calithameridi/corevus/assets/corevus-g-v0.2.png

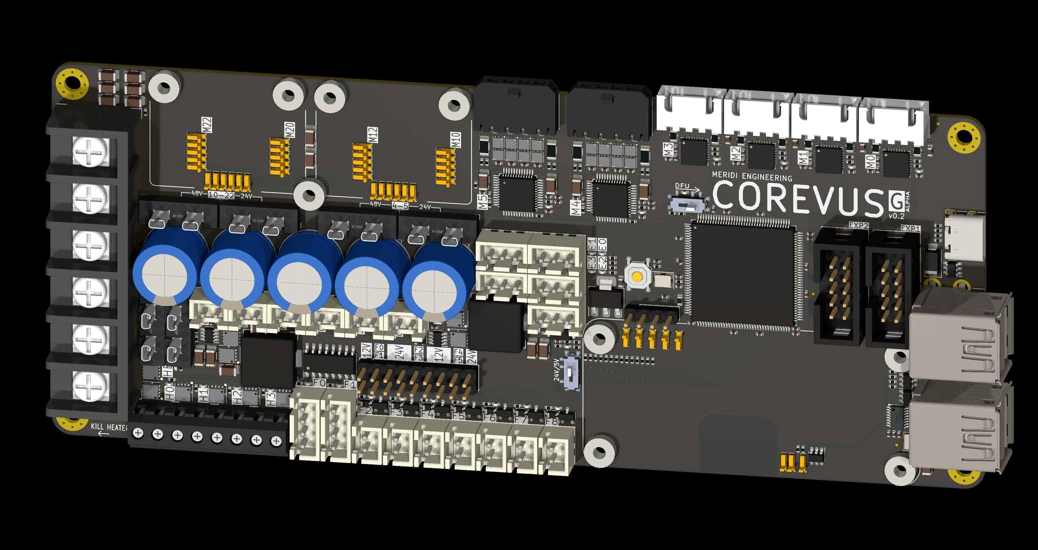
assets/corevus-g-v0.2.png
