calithameridi/corevus/assets/images/CvG-v0.4-closeup.jpg

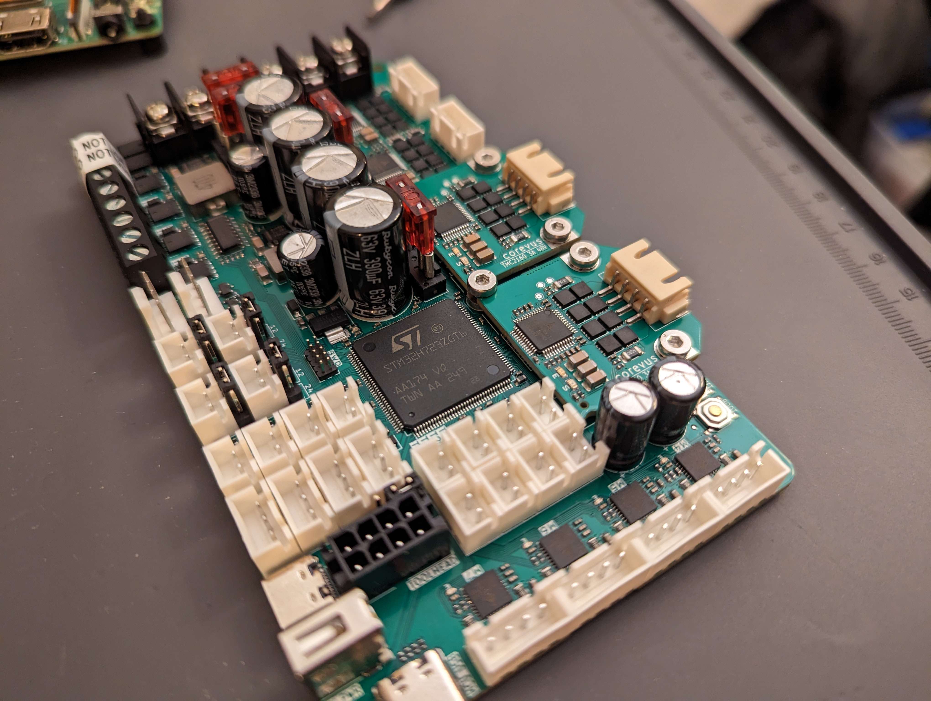
assets/images/CvG-v0.4-closeup.jpg
