calithameridi/corevus/assets/images/CvG-v0.4-topview.jpg

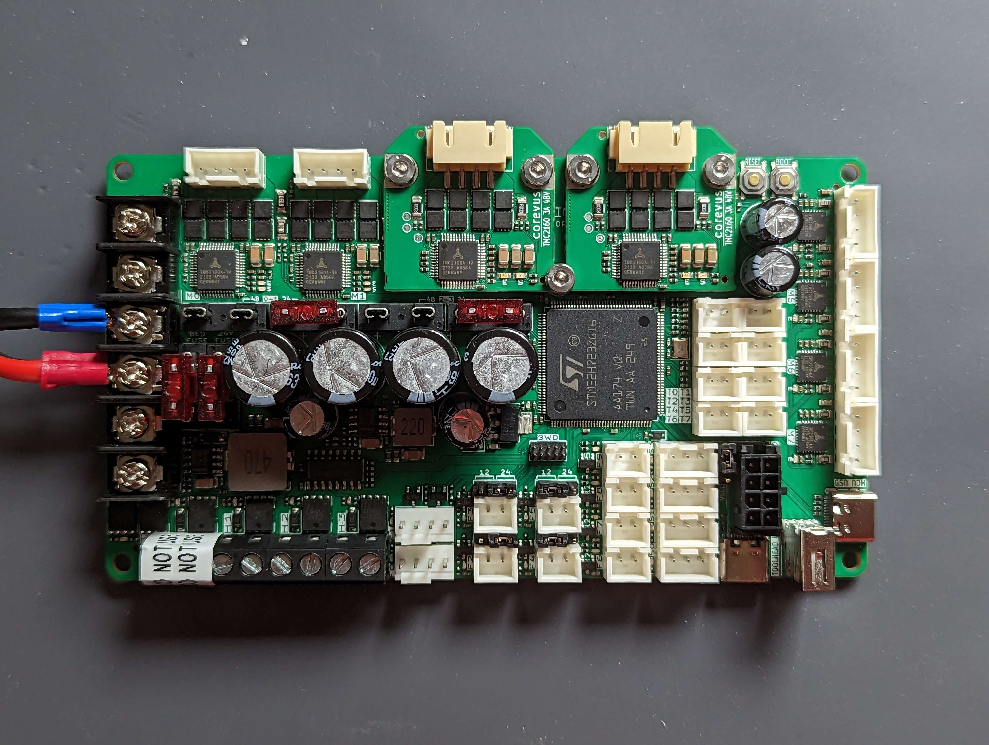
assets/images/CvG-v0.4-topview.jpg
