calithameridi/corevus/assets/images/modules/20240908_corevus_tmc2160.jpeg

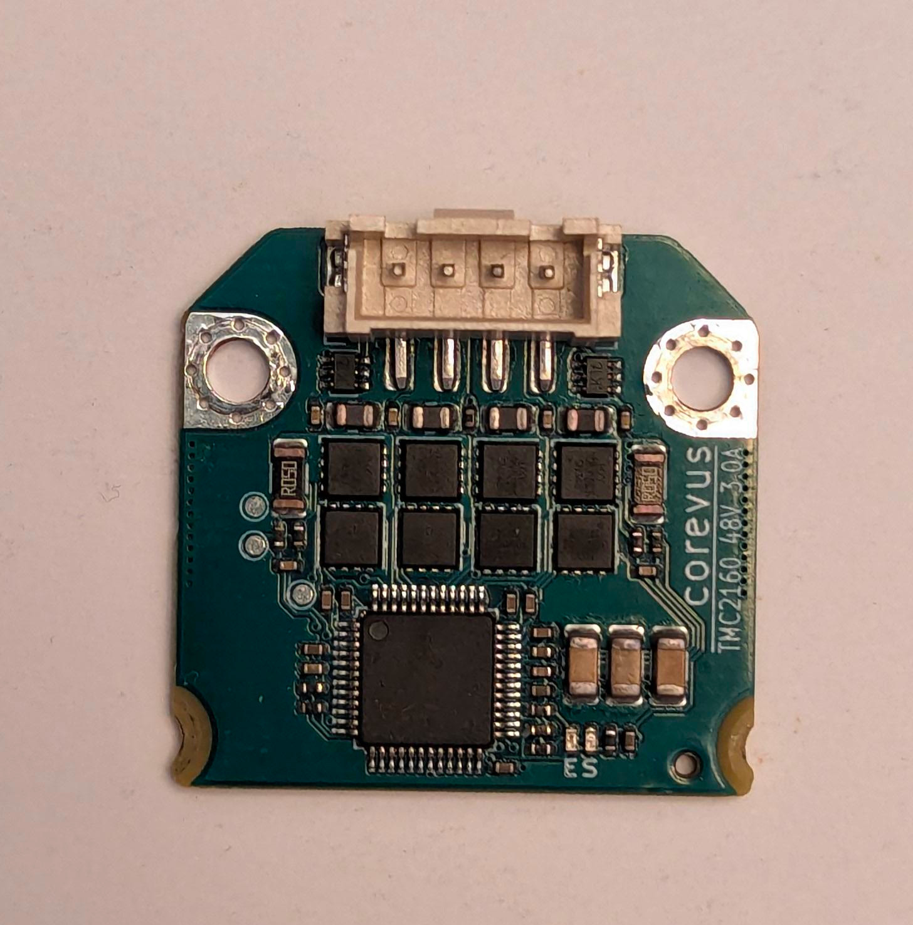
assets/images/modules/20240908_corevus_tmc2160.jpeg
