calithameridi/corevus/assets/images/modules/20240908_corevus_tmc2209.jpeg

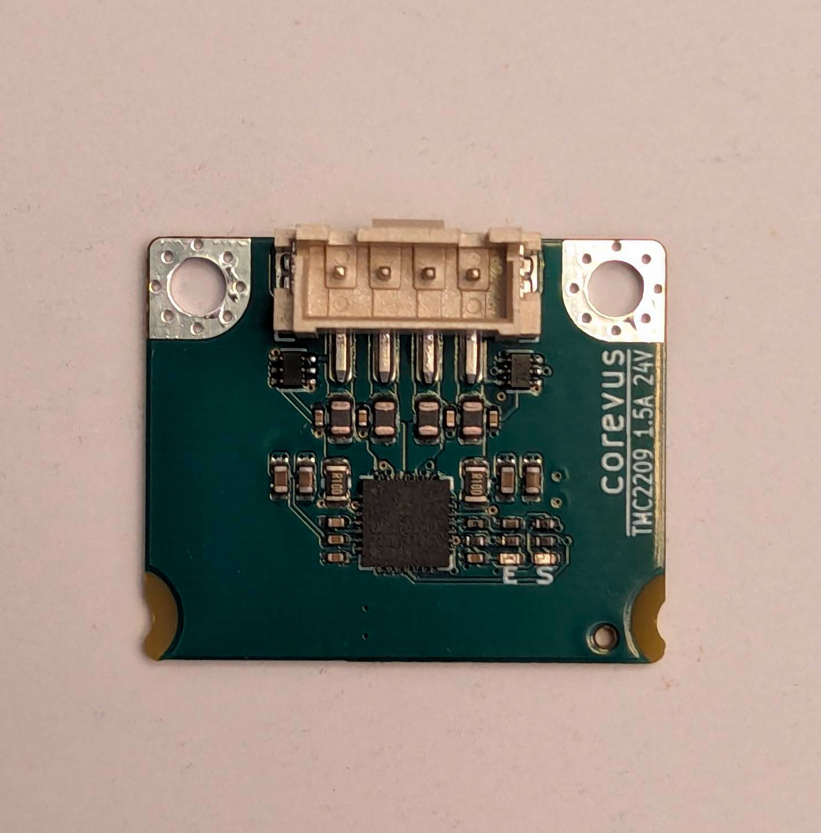
assets/images/modules/20240908_corevus_tmc2209.jpeg
