calithameridi/corevus/assets/images/PXL_20240130_212738815.MP.jpg

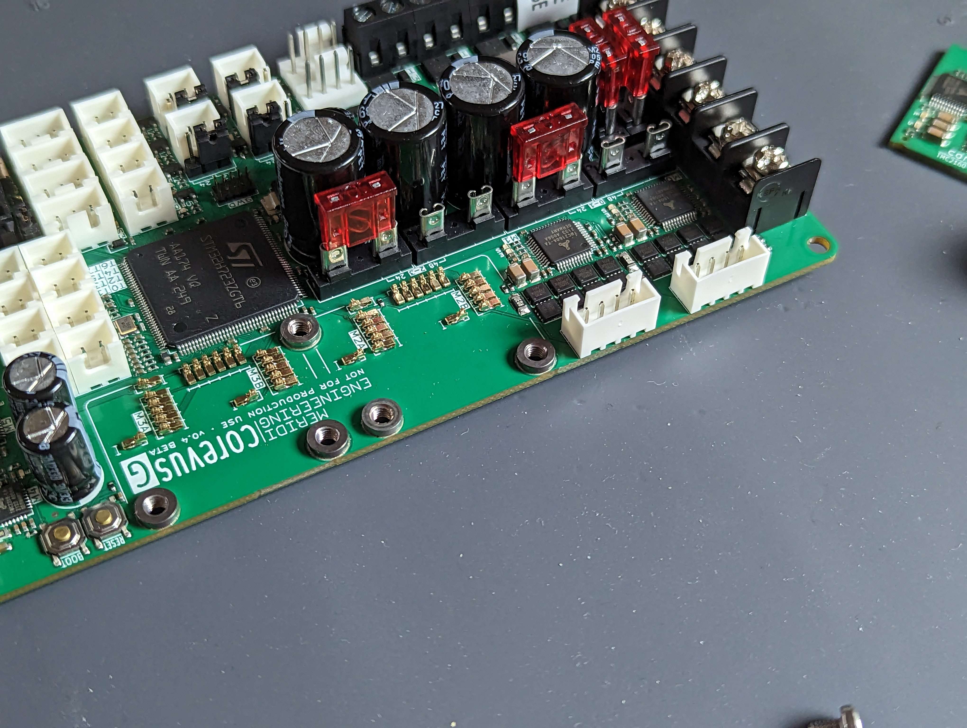
assets/images/PXL_20240130_212738815.MP.jpg
