calithameridi/corevus/assets/images/PXL_20240130_213040972.MP.jpg

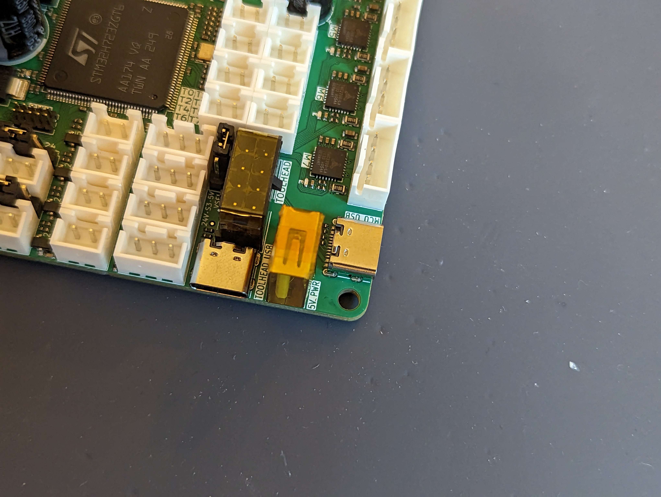
assets/images/PXL_20240130_213040972.MP.jpg
