calithameridi/corevus/hardware/corevus-m++/corevus-m++.step

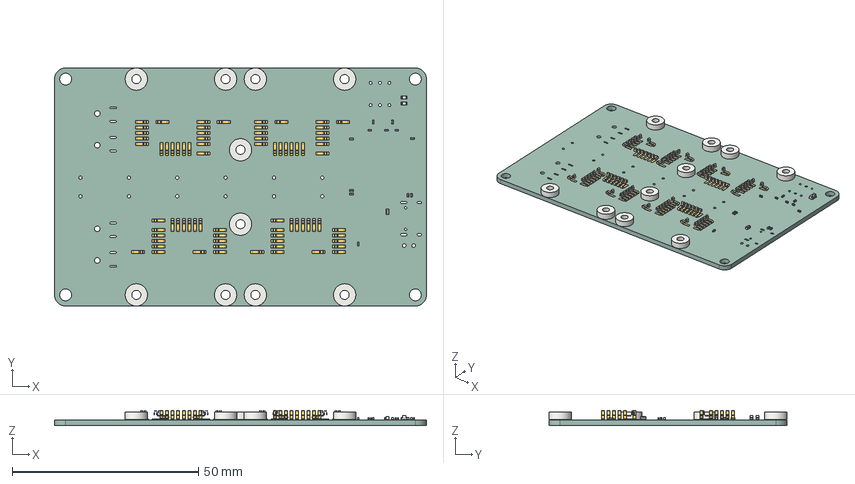
[picture p21: CAD file, 2024-05-26]
hardware/corevus-m++/corevus-m++.step
100.0 x 64.0 x 4.15 mm
Mounting_Wuerth_WA_SMSI_M3_H2mm_9774020360 x 10
C_0402_1005Metric x 12
LED_0603_1608Metric x 2
C_0603_1608Metric
corevus-m++_PCB
