calithameridi/corevus/docs/CvG-v0.4-beta/CvG-v0.4-config-setup.md

# Corevus-G v0.4 beta test manual

Document incomplete, work in progress
*See also*: [Hardware Overview](./CvG-v0.4-hardware-overview.md)

# Critical bug fix

Early testers found [a bug in the Klipper STM32H723 source code](https://github.com/DangerKlippers/danger-klipper/pull/148) that would fail to configure the microcontroller's clock frequency correctly, causing serious problems. I am working on adding this to mainline Klipper, but in the meantime, please [convert your system to DangerKlipper](https://github.com/DangerKlippers/danger-klipper/?tab=readme-ov-file#switch-to-danger-klipper) (which, as of the latest version, has the fix already applied), and reflash the MCU with the following instructions.

# Flashing Klipper
Flashing the firmware is fairly straightforward and mostly similar to how you would flash any control board through USB-DFU:

- Unplug **everything** from the board except the USB connection to the klipper host (or any machine with the klipper build chain). You may find it helpful to take a photo before dismantling attached cables
- On the klipper host, run `cd ~/klipper` to enter the klipper source directory
- Run `make clean` to delete previous builds and `make menuconfig`
- In the configuration menu, select the following parameters: 
	```
	[*] Enable extra low-level configuration options
    Micro-controller Architecture (STMicroelectronics STM32)  --->
    Processor model (STM32H723)  --->
    Bootloader offset (No bootloader)  --->
    Clock Reference (12 MHz crystal)  --->
    Communication interface (USB (on PA11/PA12))  --->
	```
- Save and exit the configuration menu
- Switch the microcontroller into DFU mode by holding down the BOOT pushbutton and then pressing and releasing the RESET pushbutton (the STM32 should show up as '0483:df11 STMicroelectronics STM device in DFU mode')
- Run `make` to compile the Klipper MCU firmware. On most Raspberry Pis with a quad-core processor, use `make -j4` to use all CPU cores and save substantial time.
- Flash the board with `make flash FLASH_DEVICE=0483:df11`. This may return 'error 255', which does not affect functionality
- Check `lsusb`, the board should show up as '1d50:614e OpenMoko, Inc. stm32h723xx'.
- (Re)install the board in accordance to your wiring scheme.

Configuring the board should also be straightforward — with the board connected to your host computer via USB, run `ls /dev/serial/by-id/*` and copy the resulting directory path into the `serial:` section under `[mcu]` in your Klipper config file. 

After doing this, verify in the settings / machine panel that the clock frequency of the STM32H723 MCU is 400 MHz _and not 480 MHz_. If you see 480 MHz, the machine will not work — check that you're on the latest version of DangerKlipper and/or ping me on Discord.

# Configuration 

Reading through the [Klipper configuration reference](https://www.klipper3d.org/Config_Reference.html) will probably be of good help here.

## Pin table
Add the following section to your configuration. This defines human readable pins for pin names such that you won't have to reference the schematic for the microcontroller pin names. For example, you can call `T1` to denote the pin connected to thermistor T1 and `M4_STEP` to denote the pin connected to the M4 driver step signal.

```
[board_pins corevus-g] ### Corevus-G v0.4 Pin Aliases ###
mcu: # specify name given to corevus microcontroller, typically 'mcu'
aliases:
# TMC2160 drivers
	M0_STEP = PG8,  M0_DIR = PG7, M0_EN = PG5,  M0_CS = PG6, M0_DIAG1 = PG4,
	M1_STEP = PD15, M1_DIR = PG2, M1_EN = PD14, M1_CS = PG3, M1_DIAG1 = PD13,
# Driver expansion ports
	M2A_STEP = PB12, M2A_DIR = PE12, M2A_EN = PE13, M2A_CS = PE14, M2A_DIAG = PE15,
	M2B_STEP = PD12, M2B_DIR = PD11, M2B_EN = PD10, M2B_CS = PD9,  M2B_DIAG = PD8,
	M3A_STEP = PF13, M3A_DIR = PF14, M3A_EN = PF15, M3A_CS = PG1,  M3A_DIAG = PG0,
	M3B_STEP = PE11, M3B_DIR = PE10, M3B_EN = PE9,  M3B_CS = PE8,  M3B_DIAG = PE7,
# TMC2208 drivers
	M4_STEP = PF11, M4_DIR = PC4,  M4_EN = PC5,  M4_UART = PF12,
	M5_STEP = PF3,  M5_DIR = PF1,  M5_EN = PF2,  M5_UART = PF4,
	M6_STEP = PC15, M6_DIR = PC13, M6_EN = PC14, M6_UART = PF0,
	M7_STEP = PE4,  M7_DIR = PE2,  M7_EN = PE3,  M7_UART = PE5,
# Heaters
	HB = PD2, H0 = PD1, H1 = PD0, H2 = PD3, H3 = PD4,
# Fans
	F0 = PA10, F1 = PA15,
	F2 = PB4, F3 = PB3, F4 = PB6, F5 = PB5, 
	F6 = PB9, F7 = PB8, F8 = PE6, F9 = PB7,
	F0_FG = PC11, F1_FG = PC10,
# Thermistors
	T0 = PA0, T1 = PA1, T2 = PC2, T3 = PC3,
	T4 = PC0, T5 = PC1, T6 = PF6, T7 = PF7,
	M1_THERM = PB1, M2_THERM = PB0, M3_THERM = PF8,
	M4_THERM = PA4, 5V_THERM = PF9, 12V_THERM = PF10,
# Endstops
	S0 = PG12, S1 = PG13, S2 = PG14, S3 = PG15
```

## Thermistors
Corevus-G features 4 onboard thermistors soldered on to measure temperature in key locations. These temperature sensors not only present a useful diagnostic tool but also provide an extra layer of safety from serious errors such as motor driver misconfigurations. 

Add the following section to your config file. If the default `max_temp` of 85°C is too low, and providing more cooling / airflow to the board is not an option, you may have to increase the `max_temp`. For safety it is not recommended to increase this value past 100°C. 

Driver expansion modules have their own built-in thermistors. If you have drivers installed in ports M2 and/or M3 their temperatures can be read out by uncommenting the relevant sections.

```
### Corevus-G v0.4 Thermistors ###

[thermistor CvBoardTherm]
temperature1: 25.0
resistance1: 10000.0
beta: 3950

[temperature_sensor M1_Driver]
sensor_type: CvBoardTherm
sensor_pin: M1_THERM
min_temp: -20
max_temp: 85

[temperature_sensor M4_Driver]
sensor_type: CvBoardTherm
sensor_pin: M4_THERM
min_temp: -20
max_temp: 85

[temperature_sensor 12V]
sensor_type: CvBoardTherm
sensor_pin: 12V_THERM
min_temp: -20
max_temp: 85

[temperature_sensor 5V]
sensor_type: CvBoardTherm
sensor_pin: 5V_THERM
min_temp: -20
max_temp: 85

# Uncomment if using expansion ports M2 and/or M3

#[temperature_sensor M2_Driver]
#sensor_type: CvBoardTherm
#sensor_pin: M2_THERM
#min_temp: -20
#max_temp: 85

#[temperature_sensor M3_Driver]
#sensor_type: CvBoardTherm
#sensor_pin: M3_THERM
#min_temp: -20
#max_temp: 85
```

## Motors 

The following klipper configuration code uses the TMC5160 module — works, as the two chips are mostly register compatible and Klipper does not use 5160-specific features. A dedicated TMC2160 module is being tested and should be upstreamed soon. 

Important to note: **you must check the driver sense resistor values** and add them to your configuration file. Failure to do so may result in destruction of motors, drivers, or both — this is a scenario that has happened numerous times so save yourself the effort of dealing with an electrical fire. For v0.4 tmc2160s, the value is 30 mΩ — however, due to reported issues with low sense resistances this value is likely to change in the future. Check the physical resistors on the board before configuring!

This code configures the TMC2160 drivers M0 and M1 (just substitute the pin alias names). Start out at a low run current and increase it to your preferred value once you have established that the drivers work.
```
[stepper-<n>]
step_pin: M0_STEP
dir_pin: M0_DIR
enable_pin: !M0_EN
rotation_distance: 
microsteps:
full_steps_per_rotation: 200
endstop_pin:
#position_min: 0
position_endstop:
position_max:
#homing_speed: 5.0
#homing_retract_dist: 5.0
#homing_retract_speed:
#second_homing_speed:
#homing_positive_dir:

[tmc5160 stepper_<n>]
cs_pin: M0_STEP
spi_bus: spi2
interpolate: True
run_current: 1.0
hold_current: 1.0
sense_resistor: 0.03 # YOU MUST CHECK THIS AGAINST YOUR HARDWARE
#stealthchop_threshold: 0
# Relevant for sensorless homing
driver_SGT: 0
diag1_pin:
	# For integrated 2160s this is M0_DIAG1 or M1_DIAG1, for TMC2160 driver expansion modules this is M2A_DIAG or similar (with no '1')

```
This code configures a single TMC2160 driver module bolted to the M2 slot — the driver is electrically connected to the signals labeled with M2A.
