calithameridi/corevus/hardware/motor_drivers/driver-dual-tmc2160/driver-dual-tmc2160.kicad_pcb

## KiCad design hardware/motor_drivers/driver-dual-tmc2160/driver-dual-tmc2160.kicad_pcb (2025-02-08)

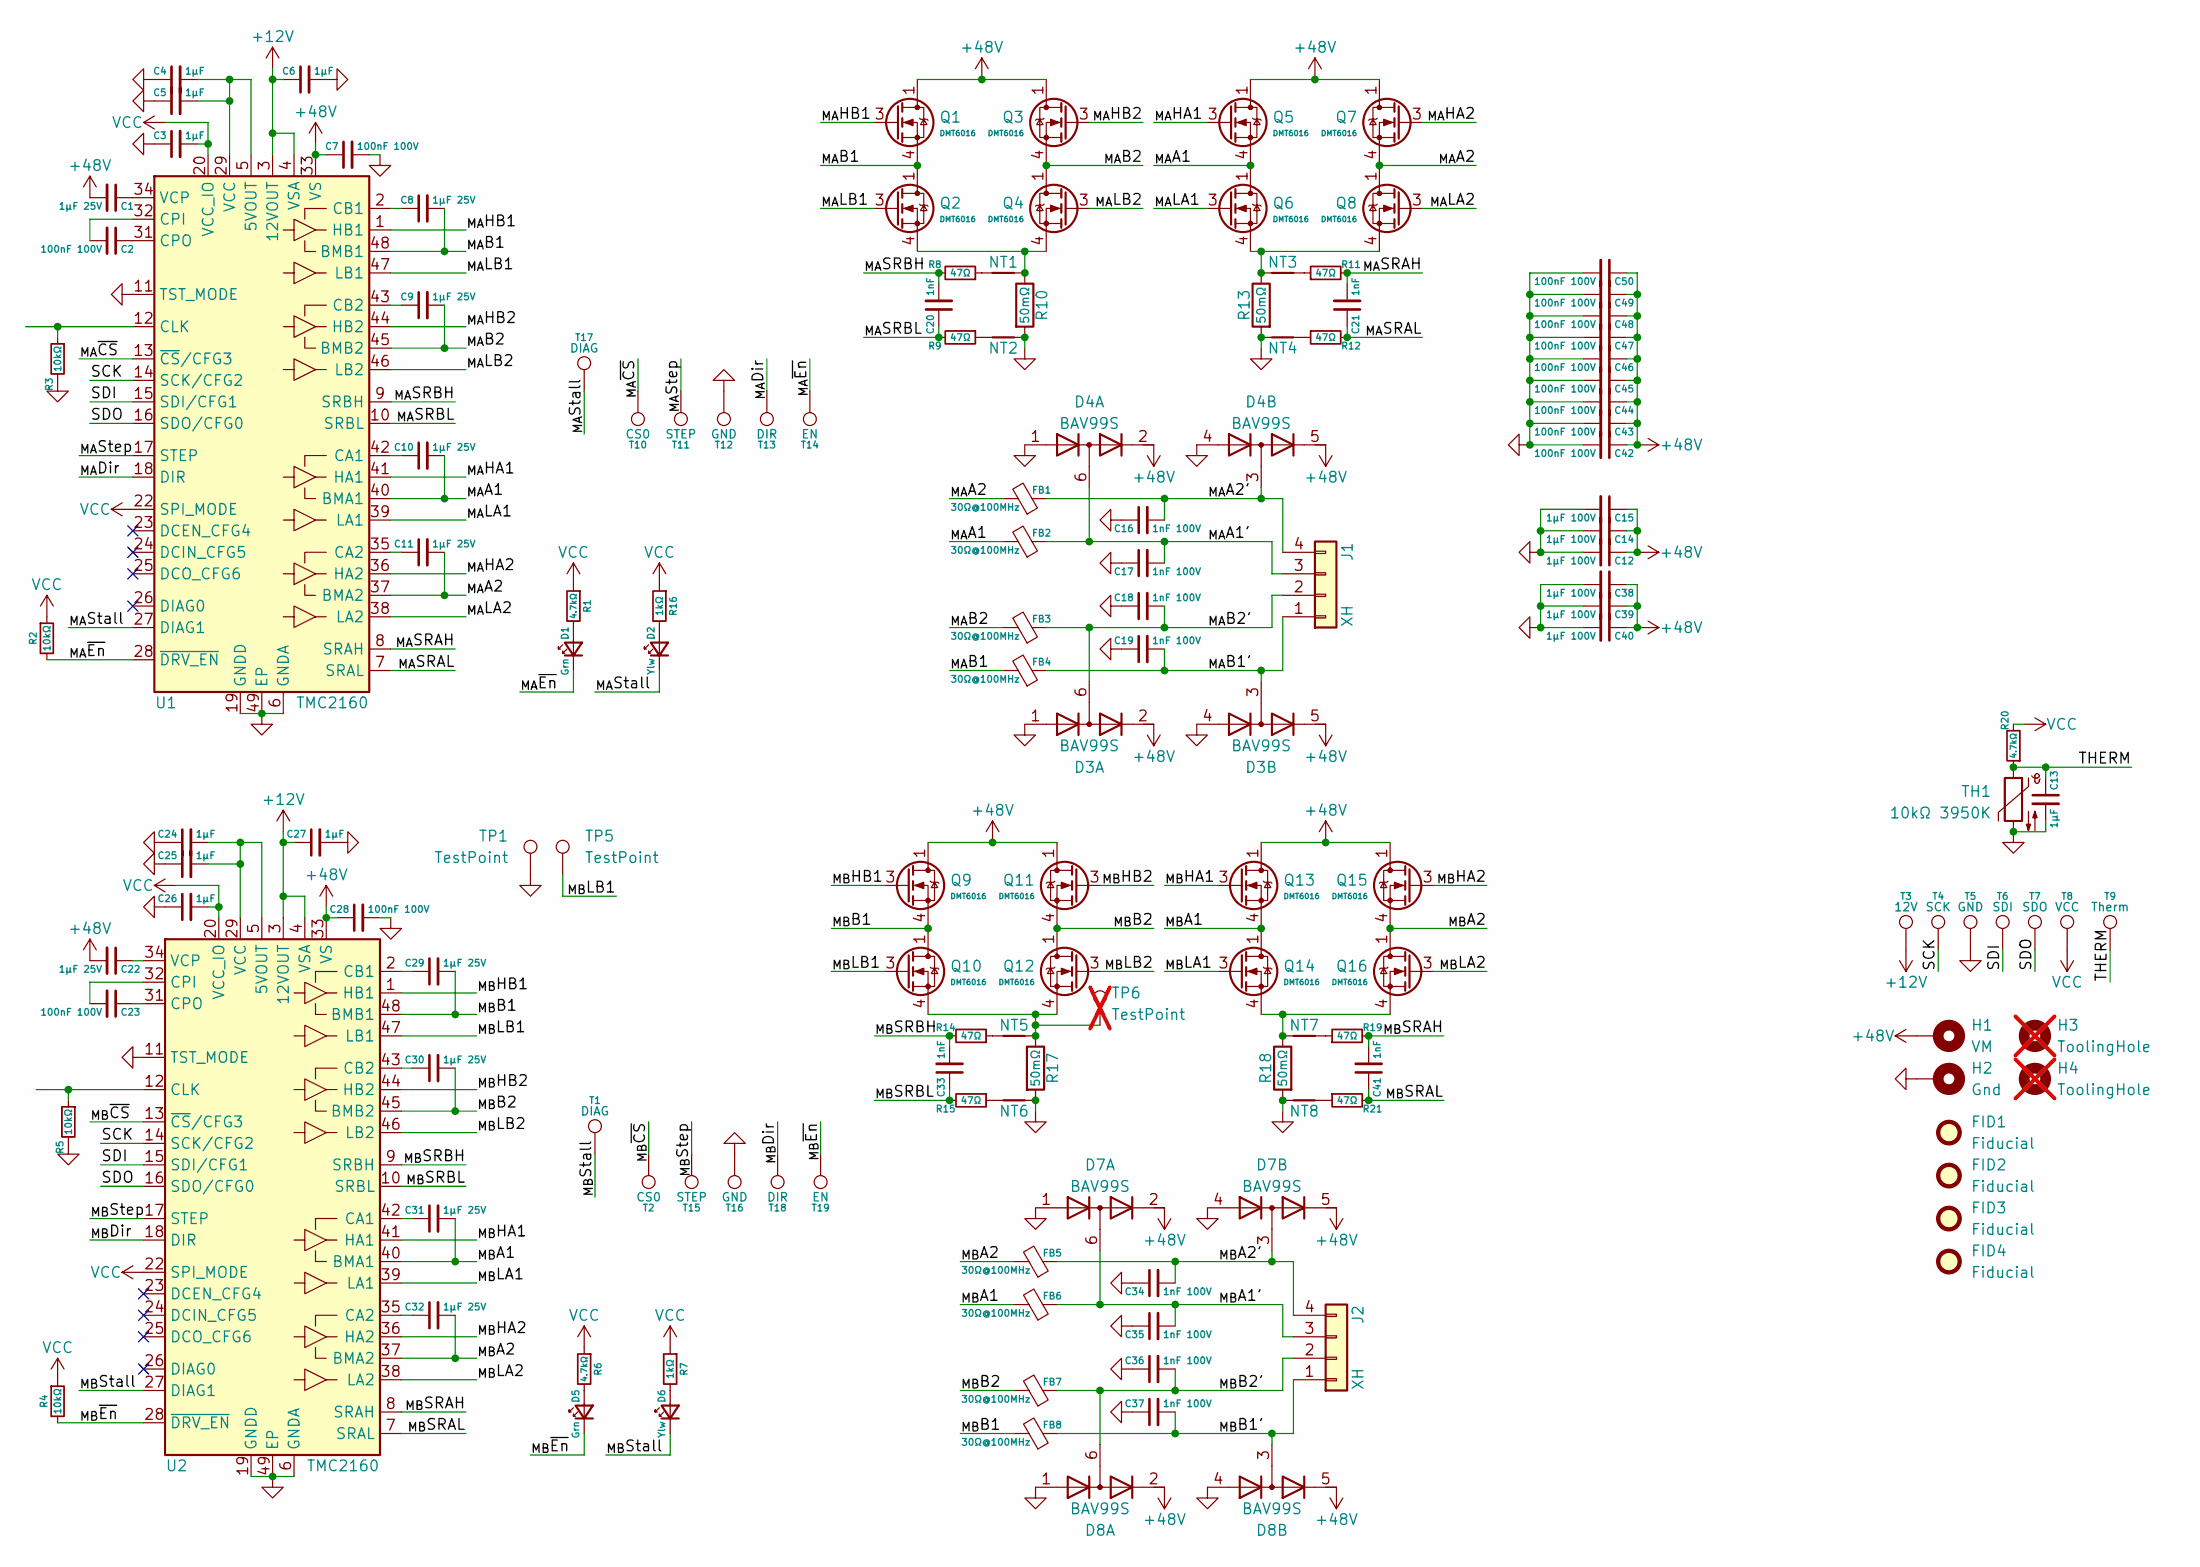
[picture p25: schematic driver-dual-tmc2160.kicad_sch, TMC2160 Stepper Driver Module]

Parts:
C1, C8, C9, C10, C11, C22, C29, C30, C31, C32: 1μF 25V; 0402C
C2, C7, C23, C28, C42, C43, C44, C45, C46, C47, C48, C49, C50: 100nF 100V; 0402C
C3, C5, C25, C26: 1µF; 0402C
C4, C6, C13, C24, C27: 1μF; 0402C
C12, C14, C15, C38, C39, C40: 1μF 100V; C_1206_3216Metric
C16, C17, C18, C19, C34, C35, C36, C37: 1nF 100V; 0402C
C20, C21, C33, C41: 1nF; 0402C
D1, D5: Grn; 0603LED
D2, D6: Ylw; 0603LED
D3, D4, D7, D8: BAV99S; SOT-363_SC-70-6
FB1, FB2, FB3, FB4, FB5, FB6, FB7, FB8: 30Ω@100MHz; R_1206_3216Metric
FID1, FID2, FID3, FID4: Fiducial; Fiducial_0.5mm_Mask1mm
H1: VM; MountingHole_M3_Driver
H2: Gnd; MountingHole_M3_Driver
H3, H4: ToolingHole; not fitted
J1, J2: XH; JST_XH_1x04
NT1, NT2, NT3, NT4, NT5, NT6, NT7, NT8: NetTie_2; NetTie-2_SMD_Pad0.15mm
Q1, Q2, Q3, Q4, Q5, Q6, Q7, Q8, Q9, Q10, Q11, Q12, Q13, Q14, Q15, Q16: DMT6016; DMT6016LFDF; LCSC Part C460205
R1, R6, R20: 4.7kΩ; 0402R
R2, R3, R4, R5: 10kΩ; 0402R
R7, R16: 1kΩ; 0402R
R8, R9, R11, R12, R14, R15, R19, R21: 47Ω; 0402R
R10, R13, R17, R18: 50mΩ; R_1206_3216Metric
T1, T17: DIAG; LGA_Land_2.5mm
T2, T10: CS0; LGA_Land_2.5mm
T3: 12V; LGA_Land_2.5mm
T4: SCK; LGA_Land_2.5mm
T5, T12, T16: GND; LGA_Land_2.5mm
T6: SDI; LGA_Land_2.5mm
T7: SDO; LGA_Land_2.5mm
T8: VCC; LGA_Land_2.5mm
T9: Therm; LGA_Land_2.5mm
T11, T15: STEP; LGA_Land_2.5mm
T13, T18: DIR; LGA_Land_2.5mm
T14, T19: EN; LGA_Land_2.5mm
TH1: 10kΩ 3950K; 0402R
TP1, TP5: TestPoint; TestPoint_Pad_D1.0mm
TP6: TestPoint; TestPoint_Pad_D1.0mm; not fitted
U1, U2: TMC2160; TMCx160

Connections:
+12V: C6.1, C27.1, T3.1, U1.3 (12VOUT), U1.4 (VSA), U2.3 (12VOUT), U2.4 (VSA)
+48V: C1.2, C7.1, C12.1, C14.1, C15.1, C22.2, C28.1, C38.1, C39.1, C40.1, C42.1, C43.1, C44.1, C45.1, C46.1, C47.1, C48.1, C49.1, C50.1, D3.2 (K2), D3.5 (K4), D4.2 (K2), D4.5 (K4), D7.2 (K2), D7.5 (K4), D8.2 (K2), D8.5 (K4), H1.1, Q1.1 (D), Q1.2 (D), Q1.5 (D), Q1.6 (D), Q1.8 (D), Q3.1 (D), Q3.2 (D), Q3.5 (D), Q3.6 (D), Q3.8 (D), Q5.1 (D), Q5.2 (D), Q5.5 (D), Q5.6 (D), Q5.8 (D), Q7.1 (D), Q7.2 (D), Q7.5 (D), Q7.6 (D), Q7.8 (D), Q9.1 (D), Q9.2 (D), Q9.5 (D), Q9.6 (D), Q9.8 (D), Q11.1 (D), Q11.2 (D), Q11.5 (D), Q11.6 (D), Q11.8 (D), Q13.1 (D), Q13.2 (D), Q13.5 (D), Q13.6 (D), Q13.8 (D), Q15.1 (D), Q15.2 (D), Q15.5 (D), Q15.6 (D), Q15.8 (D), U1.33 (VS), U2.33 (VS)
/SCK: T4.1, U1.14 (SCK/CFG2), U2.14 (SCK/CFG2)
/SDI: T6.1, U1.15 (SDI/CFG1), U2.15 (SDI/CFG1)
/SDO: T7.1, U1.16 (SDO/CFG0), U2.16 (SDO/CFG0)
/THERM: C13.1, R20.1, T9.1, TH1.1
/_{MA}A1: C10.2, FB2.2, Q5.4 (S), Q5.7 (S), Q6.1 (D), Q6.2 (D), Q6.5 (D), Q6.6 (D), Q6.8 (D), U1.40 (BMA1)
/_{MA}A1': C17.2, D4.6 (K3A4), FB2.1, J1.3
/_{MA}A2: C11.2, FB1.2, Q7.4 (S), Q7.7 (S), Q8.1 (D), Q8.2 (D), Q8.5 (D), Q8.6 (D), Q8.8 (D), U1.37 (BMA2)
/_{MA}A2': C16.2, D4.3 (K1A2), FB1.1, J1.4
/_{MA}B1: C8.2, FB4.2, Q1.4 (S), Q1.7 (S), Q2.1 (D), Q2.2 (D), Q2.5 (D), Q2.6 (D), Q2.8 (D), U1.48 (BMB1)
/_{MA}B1': C19.2, D3.3 (K1A2), FB4.1, J1.1
/_{MA}B2: C9.2, FB3.2, Q3.4 (S), Q3.7 (S), Q4.1 (D), Q4.2 (D), Q4.5 (D), Q4.6 (D), Q4.8 (D), U1.45 (BMB2)
/_{MA}B2': C18.2, D3.6 (K3A4), FB3.1, J1.2
/_{MA}Dir: T13.1, U1.18 (DIR)
/_{MA}HA1: Q5.3 (G), U1.41 (HA1)
/_{MA}HA2: Q7.3 (G), U1.36 (HA2)
/_{MA}HB1: Q1.3 (G), U1.1 (HB1)
/_{MA}HB2: Q3.3 (G), U1.44 (HB2)
/_{MA}LA1: Q6.3 (G), U1.39 (LA1)
/_{MA}LA2: Q8.3 (G), U1.38 (LA2)
/_{MA}LB1: Q2.3 (G), U1.47 (LB1)
/_{MA}LB2: Q4.3 (G), U1.46 (LB2)
/_{MA}SRAH: C21.2, R11.2, U1.8 (SRAH)
/_{MA}SRAL: C21.1, R12.2, U1.7 (SRAL)
/_{MA}SRBH: C20.2, R8.2, U1.9 (SRBH)
/_{MA}SRBL: C20.1, R9.2, U1.10 (SRBL)
/_{MA}Stall: D2.1 (K), T17.1, U1.27 (DIAG1)
/_{MA}Step: T11.1, U1.17 (STEP)
/_{MA}~CS: T10.1, U1.13 (~CS/CFG3)
/_{MA}~En: D1.1 (K), R2.2, T14.1, U1.28 (~DRV_EN)
/_{MB}A1: C31.2, FB6.2, Q13.4 (S), Q13.7 (S), Q14.1 (D), Q14.2 (D), Q14.5 (D), Q14.6 (D), Q14.8 (D), U2.40 (BMA1)
/_{MB}A1': C35.2, D7.6 (K3A4), FB6.1, J2.3
/_{MB}A2: C32.2, FB5.2, Q15.4 (S), Q15.7 (S), Q16.1 (D), Q16.2 (D), Q16.5 (D), Q16.6 (D), Q16.8 (D), U2.37 (BMA2)
/_{MB}A2': C34.2, D7.3 (K1A2), FB5.1, J2.4
/_{MB}B1: C29.2, FB8.2, Q9.4 (S), Q9.7 (S), Q10.1 (D), Q10.2 (D), Q10.5 (D), Q10.6 (D), Q10.8 (D), U2.48 (BMB1)
/_{MB}B1': C37.2, D8.3 (K1A2), FB8.1, J2.1
/_{MB}B2: C30.2, FB7.2, Q11.4 (S), Q11.7 (S), Q12.1 (D), Q12.2 (D), Q12.5 (D), Q12.6 (D), Q12.8 (D), U2.45 (BMB2)
/_{MB}B2': C36.2, D8.6 (K3A4), FB7.1, J2.2
/_{MB}Dir: T18.1, U2.18 (DIR)
/_{MB}HA1: Q13.3 (G), U2.41 (HA1)
/_{MB}HA2: Q15.3 (G), U2.36 (HA2)
/_{MB}HB1: Q9.3 (G), U2.1 (HB1)
/_{MB}HB2: Q11.3 (G), U2.44 (HB2)
/_{MB}LA1: Q14.3 (G), U2.39 (LA1)
/_{MB}LA2: Q16.3 (G), U2.38 (LA2)
/_{MB}LB1: Q10.3 (G), TP5.1, U2.47 (LB1)
/_{MB}LB2: Q12.3 (G), U2.46 (LB2)
/_{MB}SRAH: C41.2, R19.2, U2.8 (SRAH)
/_{MB}SRAL: C41.1, R21.2, U2.7 (SRAL)
/_{MB}SRBH: C33.2, R14.2, U2.9 (SRBH)
/_{MB}SRBL: C33.1, R15.2, U2.10 (SRBL)
/_{MB}Stall: D6.1 (K), T1.1, U2.27 (DIAG1)
/_{MB}Step: T15.1, U2.17 (STEP)
/_{MB}~CS: T2.1, U2.13 (~CS/CFG3)
/_{MB}~En: D5.1 (K), R4.2, T19.1, U2.28 (~DRV_EN)
GND: C3.1, C4.1, C5.1, C6.2, C7.2, C12.2, C13.2, C14.2, C15.2, C16.1, C17.1, C18.1, C19.1, C24.1, C25.1, C26.1, C27.2, C28.2, C34.1, C35.1, C36.1, C37.1, C38.2, C39.2, C40.2, C42.2, C43.2, C44.2, C45.2, C46.2, C47.2, C48.2, C49.2, C50.2, D3.1 (A1), D3.4 (A3), D4.1 (A1), D4.4 (A3), D7.1 (A1), D7.4 (A3), D8.1 (A1), D8.4 (A3), H2.1, NT2.2, NT4.1, NT6.2, NT8.1, R3.2, R5.2, R10.2, R13.2, R17.2, R18.2, T5.1, T12.1, T16.1, TH1.2, TP1.1, U1.6 (GNDA), U1.11 (TST_MODE), U1.19 (GNDD), U1.30 (GNDD), U1.49 (EP), U2.6 (GNDA), U2.11 (TST_MODE), U2.19 (GNDD), U2.30 (GNDD), U2.49 (EP)
unnamed: D1.2 (A), R1.2
unnamed: D2.2 (A), R16.2
unnamed: D5.2 (A), R6.2
unnamed: D6.2 (A), R7.2
unnamed: NT1.1, R8.1
unnamed: NT1.2, Q2.4 (S), Q2.7 (S), Q4.4 (S), Q4.7 (S), R10.1
unnamed: NT2.1, R9.1
unnamed: NT3.1, Q6.4 (S), Q6.7 (S), Q8.4 (S), Q8.7 (S), R13.1
unnamed: NT3.2, R11.1
unnamed: NT4.2, R12.1
unnamed: NT5.1, R14.1
unnamed: NT5.2, Q10.4 (S), Q10.7 (S), Q12.4 (S), Q12.7 (S), R17.1, TP6.1
unnamed: NT6.1, R15.1
unnamed: NT7.1, Q14.4 (S), Q14.7 (S), Q16.4 (S), Q16.7 (S), R18.1
unnamed: NT7.2, R19.1
unnamed: NT8.2, R21.1
unnamed: C4.2, C5.2, U1.5 (5VOUT), U1.29 (VCC)
unnamed: C10.1, U1.42 (CA1)
unnamed: C11.1, U1.35 (CA2)
unnamed: C8.1, U1.2 (CB1)
unnamed: C9.1, U1.43 (CB2)
unnamed: R3.1, U1.12 (CLK)
unnamed: C2.2, U1.32 (CPI)
unnamed: C2.1, U1.31 (CPO)
unnamed: C1.1, U1.34 (VCP)
unnamed: C24.2, C25.2, U2.5 (5VOUT), U2.29 (VCC)
unnamed: C31.1, U2.42 (CA1)
unnamed: C32.1, U2.35 (CA2)
unnamed: C29.1, U2.2 (CB1)
unnamed: C30.1, U2.43 (CB2)
unnamed: R5.1, U2.12 (CLK)
unnamed: C23.2, U2.32 (CPI)
unnamed: C23.1, U2.31 (CPO)
unnamed: C22.1, U2.34 (VCP)
VCC: C3.2, C26.2, R1.1, R2.1, R4.1, R6.1, R7.1, R16.1, R20.2, T8.1, U1.20 (VCC_IO), U1.21 (VCC_IO), U1.22 (SPI_MODE), U2.20 (VCC_IO), U2.21 (VCC_IO), U2.22 (SPI_MODE)

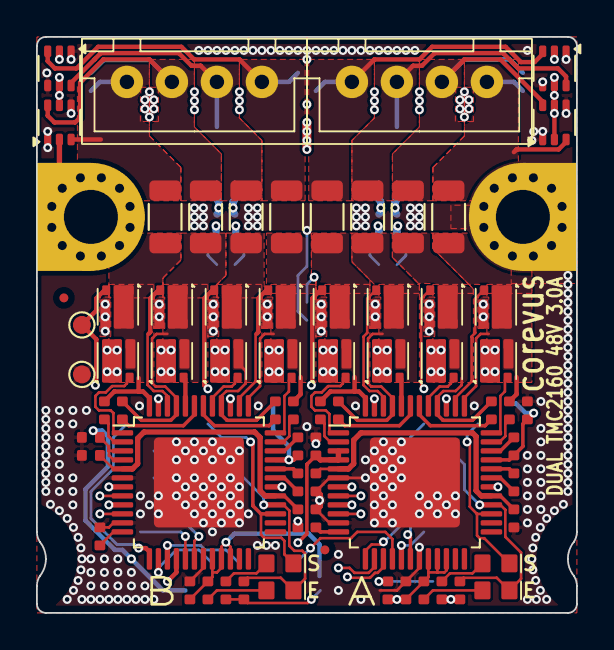
[picture p26: board driver-dual-tmc2160.kicad_pcb from above]

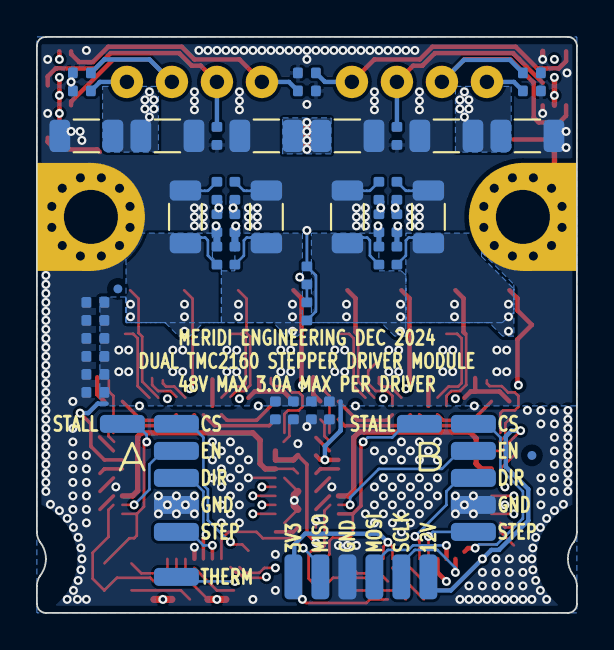
[picture p27: board driver-dual-tmc2160.kicad_pcb from below]

Board: 4 copper layers, 30.0 x 32.0 mm, 143 parts (71 on the bottom side), 92 nets.
