calithameridi/corevus/hardware/corevus-toolboard/corevus-toolboard.kicad_pcb

## KiCad design hardware/corevus-toolboard/corevus-toolboard.kicad_pcb (2025-02-08)

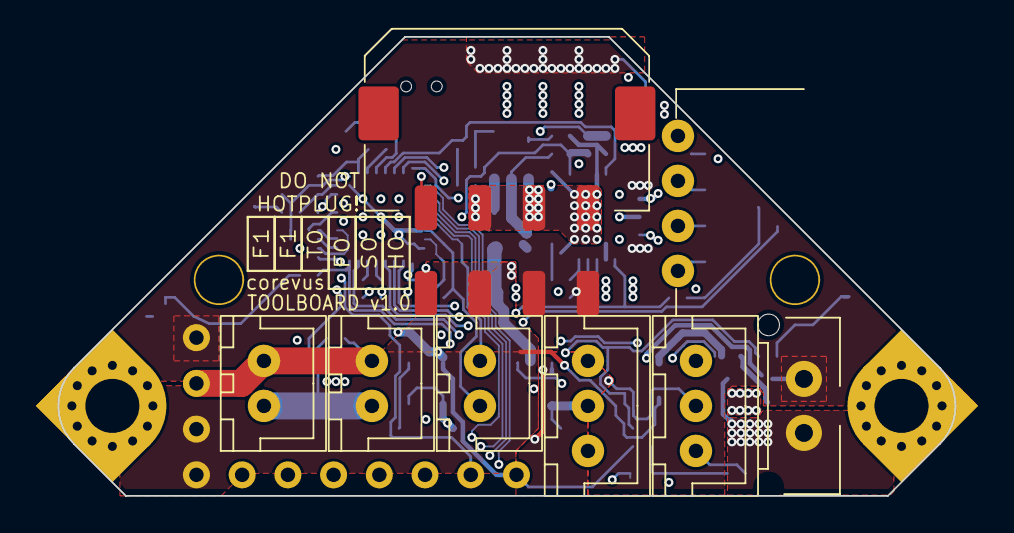
[picture p28: board corevus-toolboard.kicad_pcb from above]

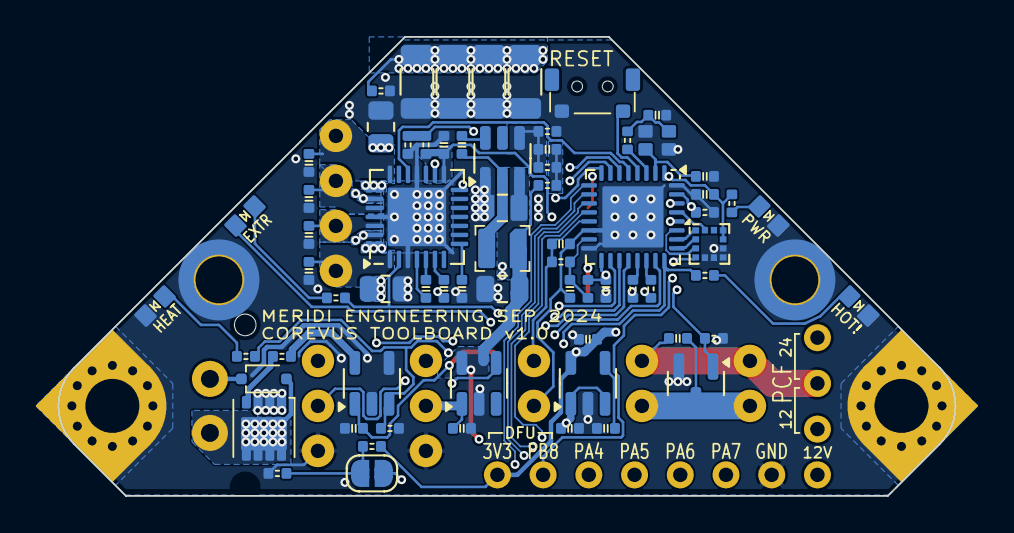
[picture p29: board corevus-toolboard.kicad_pcb from below]

Board: 4 copper layers, 49.8 x 25.5 mm, 84 parts (72 on the bottom side), 62 nets.

Parts:
C1, C4, C5, C6, C11, C12, C13, C26, C34: 1µF; 0402C
C2, C3: 10pF; 0402C
C7: 100nF; 0402C
C8: 100nF 16V; 0402C
C9: 22nF 50V; 0402C
C14, C15, C16, C17: 10µF 50V; C_1206_3216Metric
C18, C19, C20, C21: 470pF; 0402C
C23: 100nF 50V; 0402C
C28: 68pF; 0402C
C29: 100nF 25V; 0402C
C31: 10nF; 0402C
C32: 10µF 25V; C_0805_2012Metric
C33: 10µF; C_0805_2012Metric
D1: 4148; D_SOD-323
D2: Red; 0603LED
D3: Grn; 0603LED
D4: Wht; 0603LED
D5: Ylw; 0603LED
FB1: GZ1005; 0402
H1, H2: M3 Hole; MountingHole_M3_Driver_Corner
H3, H4: M2 Standoff; Sinhoo_TH162010
J1: MF3 1x2P; Molex_Micro-Fit-3.0_436500215
J2, J9: XH 1x3P; JST_XH_1x03
J3: MX3.0 2x4P; XKB_X3025WRS-2x04E
J4: XH 1x4P; JST_XH_1x04-Side
J5, J6, J7: XH 1x2P; JST_XH_1x02
J8: 1x8P; PinHeader_1x08_P2.54mm_Vertical
J10: 1x3P; PinHeader_1x03_P2.54mm_Vertical
JP1: Jumper_2_Small_Open; SolderJumper-2_P1.3mm_Open_RoundedPad1.0x1.5mm
L1: 10µH; L_Changjiang_FTC2520
NT1: NetTie_2; NetTie-2_SMD_Pad0.1mm
Q2: NMOS; MOSFET_DFN8
Q4: AO3400; SOT-23
R1, R7, R16: 4.7kΩ; 0402R
R2: 100kΩ; 0402R
R3, R4: 33Ω; 0402R
R5, R6: 100mΩ; R_0805_2012Metric
R8, R13, R17, R21: 2.2kΩ; 0402R
R9: 0Ω; 0402R
R10: 20kΩ; 0402R
R11: 150kΩ; 0402R
R12: 1kΩ; 0402R
R14, R19: 10kΩ; 0402R
R15: 51Ω; 0402R
R20: 510kΩ; 0402R
SW1: Reset; ShouHan_TS24CA
TH1, TH2: 10kΩ 3950K; 0402R
U1: LIS2DE12; LGA-12_2x2mm_P0.5mm
U2: TPS54302; SOT-23-6
U3: STM32G431KBU3; QFN-32-1EP_5x5mm_P0.5mm_EP3.45x3.45mm
U4: TMC2209-LA; TQFN-28-1EP_5x5mm_P0.5mm_EP3.25x3.25mm_ThermalVias
U6: SPX3819M5-L-3-3; SOT-23-5
U7: TPS2069CDBV; SOT-23-5
U8: UCC27517; SOT-23-5
Y1: XRCGB25; Crystal_SMD_2016-4Pin_2.0x1.6mm

Connections:
+3.3V: C5.1, C11.1, C12.1, C34.2, D3.2 (A), FB1.2, J8.8, R7.2, R16.2, R17.2, U1.9 (Vdd), U1.10 (Vdd_IO), U3.1 (VDD), U3.17 (VDD), U4.15 (VCC_IO), U6.5 (OUT)
+5V: C1.2, C33.1, J9.2, L1.2, R15.1, U6.1 (IN), U6.3 (EN), U7.5 (IN)
+12V: C29.1, C32.1, J3.6, J8.1, J10.3, U2.3 (VIN), U8.1 (VDD)
+24V: C8.2, C14.1, C15.1, C16.1, C17.1, D1.1 (K), J1.2, J3.7, J3.8, J10.1, R20.1, U4.22 (VS), U4.28 (VS)
/A1: C19.1, J4.3, U4.24 (OA1)
/A2: C18.1, J4.4, U4.21 (OA2)
/ACCEL_CS: U1.2 (~CS), U3.25 (PA15)
/ACCEL_INT1: U1.12 (INT1), U3.29 (PB6)
/B1: C21.1, J4.1, U4.1 (OB2)
/B2: C20.1, J4.2, U4.26 (OB1)
/BOOT0: J8.7, R2.2, U3.31 (PB8)
/D+: J3.5, R3.2
/D+': R3.1, U3.22 (USB_DP)
/D-: J3.1, R4.2
/D-': R4.1, U3.21 (USB_DM)
/Dir: U3.5 (PA0), U4.19 (DIR)
/F0: R8.2, U3.24 (PA14), U7.4 (EN)
/F0_FG: J2.3, U3.19 (PA9)
/F1: Q4.1 (G), R14.1, U3.30 (PB7)
/H0: R1.2, R19.2, U3.23 (PA13), U8.3 (IN+)
/H0_Gate: R9.2, U8.5 (OUT)
/PA4: J8.6, JP1.2 (B), U3.9 (ADC2_IN17)
/PA5: J8.5, U3.10 (ADC2_IN13)
/PA6: J8.4, U3.11 (ADC2_IN3)
/PA7: J8.3, U3.12 (ADC2_IN4)
/PCF_V+: C23.1, J6.2, J7.2, J10.2
/S0: J9.3, U3.20 (PA10)
/SPI1_MISO: U1.3 (SA0/SDO), U3.27 (SPI1_MISO)
/SPI1_MOSI: U1.4 (SDA/SDI), U3.28 (SPI1_MOSI)
/SPI1_SCK: U1.1 (SCL/SPC), U3.26 (SPI1_SCK)
/Step: U3.7 (PA2), U4.16 (STEP)
/T0: C26.1, J5.2, R13.1, U3.13 (PB0)
/UART: U3.8 (PA3), U4.14 (PDN/UART)
/_{FET}Therm: JP1.1 (A), R7.1, TH2.1
/_{Motor}Therm: R16.1, TH1.1, U3.6 (ADC1_IN2)
/~En: R21.2, U3.18 (PA8), U4.2 (~EN)
/~Reset: SW1.1, U3.4 (PG10)
GND: C1.1, C2.2, C3.2, C4.2, C5.2, C6.2, C11.2, C12.2, C14.2, C15.2, C16.2, C17.2, C18.2, C19.2, C20.2, C21.2, C29.2, C31.1, C32.2, C33.2, C34.1, D2.1 (K), D4.1 (K), D5.1 (K), H1.1, H2.1, H3.1, H4.1, J2.1, J3.2, J3.3, J3.4, J8.2, J9.1, NT1.1, Q2.1 (S), Q2.2 (S), Q2.3 (S), Q4.2 (S), R2.1, R5.1, R6.1, R10.2, R14.2, R19.1, R20.2, SW1.2, TH1.2, TH2.2, U1.5 (RES), U1.6 (GND), U1.7 (GND), U1.8 (GND), U2.1 (GND), U3.16 (VSS), U3.32 (VSS), U3.33 (VSS), U4.3 (GND), U4.18 (Gnd), U4.25 (NC), U4.29 (Pad), U6.2 (GND), U7.2 (GND), U8.2 (GND), U8.4 (IN-), Y1.2, Y1.4
unnamed: C3.1, R12.1, Y1.1
unnamed: C28.1, R11.1, R15.2
unnamed: D1.2 (A), J1.1, Q2.5 (D), Q2.6 (D), Q2.7 (D), Q2.8 (D)
unnamed: D2.2 (A), R1.1
unnamed: D3.1 (K), R21.1
unnamed: D4.2 (A), R17.1
unnamed: D5.2 (A), R8.1
unnamed: C6.1, J2.2, U7.1 (OUT)
unnamed: C23.2, J6.1, J7.1, Q4.3 (D)
unnamed: Q2.4 (G), R9.1
unnamed: C7.1, U2.6 (BOOT)
unnamed: C28.2, R10.1, R11.2, U2.4 (FB)
unnamed: C7.2, L1.1, U2.2 (SW)
unnamed: C2.1, U3.2 (RCC_OSC_IN), Y1.3
unnamed: R12.2, U3.3 (RCC_OSC_OUT)
unnamed: C4.1, U4.8 (5VOUT)
unnamed: R5.2, U4.23 (BRA)
unnamed: R6.2, U4.27 (BRB)
unnamed: C9.2, U4.5 (CPI)
unnamed: C9.1, U4.4 (CPO)
unnamed: C8.1, U4.6 (VCP)
unnamed: C31.2, U6.4 (BP)
VDDA: C13.2, FB1.1, R13.2, U3.15 (VDDA)
VSSA: C13.1, C26.2, J5.1, NT1.2, U3.14 (VSSA)
