calithameridi/corevus/hardware/toolboard-expansions/expansion-4x-thermistor/expansion-4x-thermistor.kicad_pcb

## KiCad design hardware/toolboard-expansions/expansion-4x-thermistor/expansion-4x-thermistor.kicad_pcb (2024-09-03)

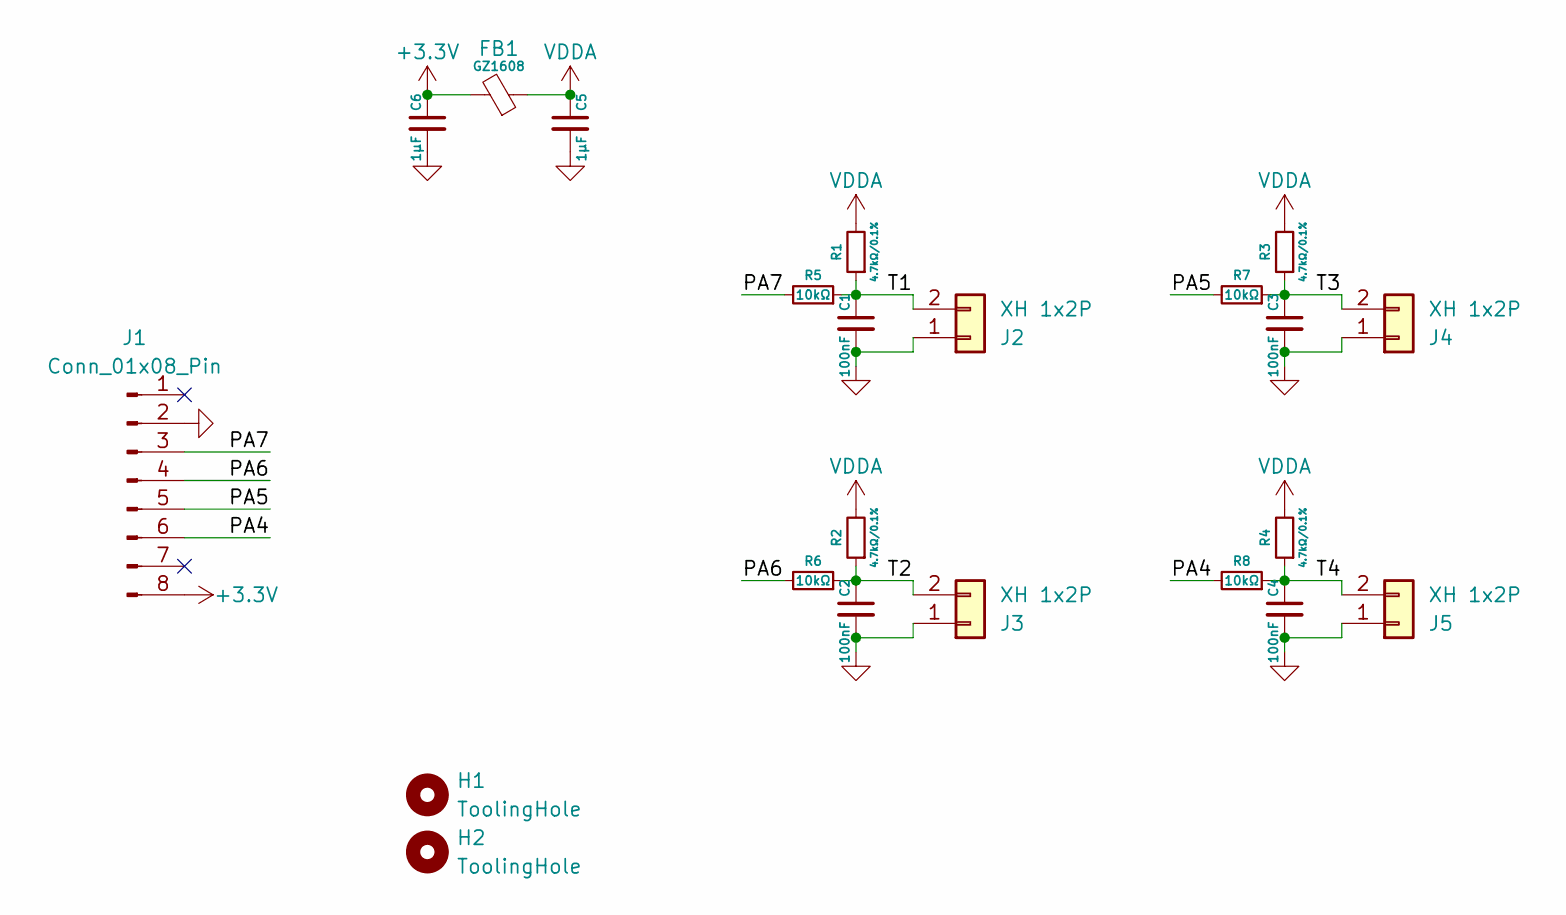
[picture p30: schematic expansion-4x-thermistor.kicad_sch]

Parts:
C1, C2, C3, C4: 100nF; 0402C
C5, C6: 1µF; 0402C
FB1: GZ1608; 0603
H1, H2: ToolingHole
J1: Conn_01x08_Pin; PinHeader_1x08_P2.54mm_Vertical
J2, J3, J4, J5: XH 1x2P; JST_XH_1x02-Side
R1, R2, R3, R4: 4.7kΩ/0.1%; 0402R
R5, R6, R7, R8: 10kΩ; 0402R

Connections:
+3.3V: C6.1, FB1.2, J1.8
/PA4: J1.6, R8.2
/PA5: J1.5, R7.2
/PA6: J1.4, R6.2
/PA7: J1.3, R5.2
/T1: C1.1, J2.2, R1.1, R5.1
/T2: C2.1, J3.2, R2.1, R6.1
/T3: C3.1, J4.2, R3.1, R7.1
/T4: C4.1, J5.2, R4.1, R8.1
GND: C1.2, C2.2, C3.2, C4.2, C5.2, C6.2, J1.2, J2.1, J3.1, J4.1, J5.1
VDDA: C5.1, FB1.1, R1.2, R2.2, R3.2, R4.2

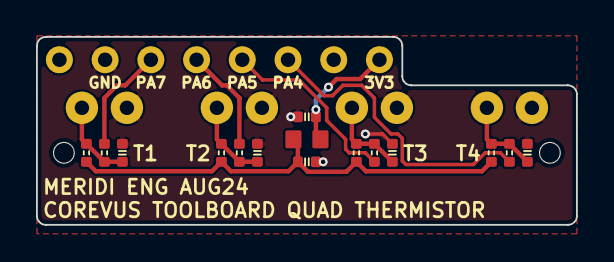
[picture p31: board expansion-4x-thermistor.kicad_pcb from above]

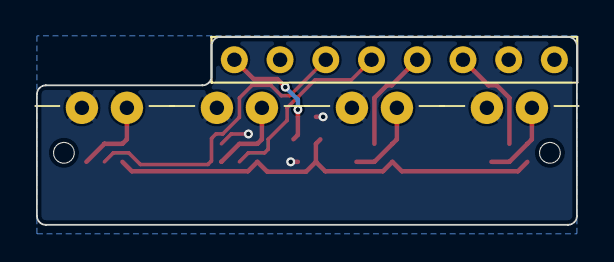
[picture p32: board expansion-4x-thermistor.kicad_pcb from below]

Board: 2 copper layers, 30.0 x 10.4 mm, 22 parts (5 on the bottom side), 11 nets.
