calithameridi/corevus/hardware/toolboard-expansions/expansion-max31856/expansion-max31856.kicad_pcb

## KiCad design hardware/toolboard-expansions/expansion-max31856/expansion-max31856.kicad_pcb (2024-09-03)

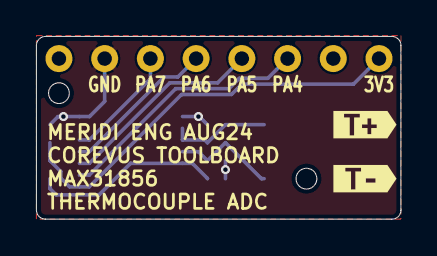
[picture p33: board expansion-max31856.kicad_pcb from above]

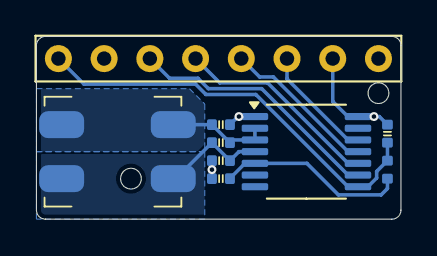
[picture p34: board expansion-max31856.kicad_pcb from below]

Board: 2 copper layers, 20.2 x 10.2 mm, 13 parts (9 on the bottom side), 9 nets.

Parts:
C1, C2, C5: 100nF; 0402C
C3, C4: 10nF; 0402C
H1, H2: ToolingHole
J1: Conn_01x08_Socket; PinHeader_1x08_P2.54mm_Vertical
J2: WAGO 1x2P; WAGO_2059-302
R1: 0Ω; 0402
U1: MAX31856; TSSOP-14_4.4x5mm_P0.65mm
kibuzzard-66C1A6C4: G***; kibuzzard-66C1A6C4
kibuzzard-66C1A6D0: G***; kibuzzard-66C1A6D0

Connections:
+3.3V: C1.1, J1.8, R1.1, U1.8 (DVDD)
/PA4: J1.6, U1.9 (~CS)
/PA5: J1.5, U1.10 (SCK)
/PA6: J1.4, U1.11 (SDO)
/PA7: J1.3, U1.12 (SDI)
/T+: C3.2, C5.1, J2.2, U1.4 (T+)
/T-: C4.2, C5.2, J2.1, U1.2 (BIAS), U1.3 (T-)
GND: C1.2, C2.2, C3.1, C4.1, J1.2, U1.1 (AGND), U1.14 (DGND)
VDDA: C2.1, R1.2, U1.5 (AVDD)
