calithameridi/corevus/hardware/toolboard-bridge/toolboard-bridge.kicad_pcb

## KiCad design hardware/toolboard-bridge/toolboard-bridge.kicad_pcb (2024-08-08)

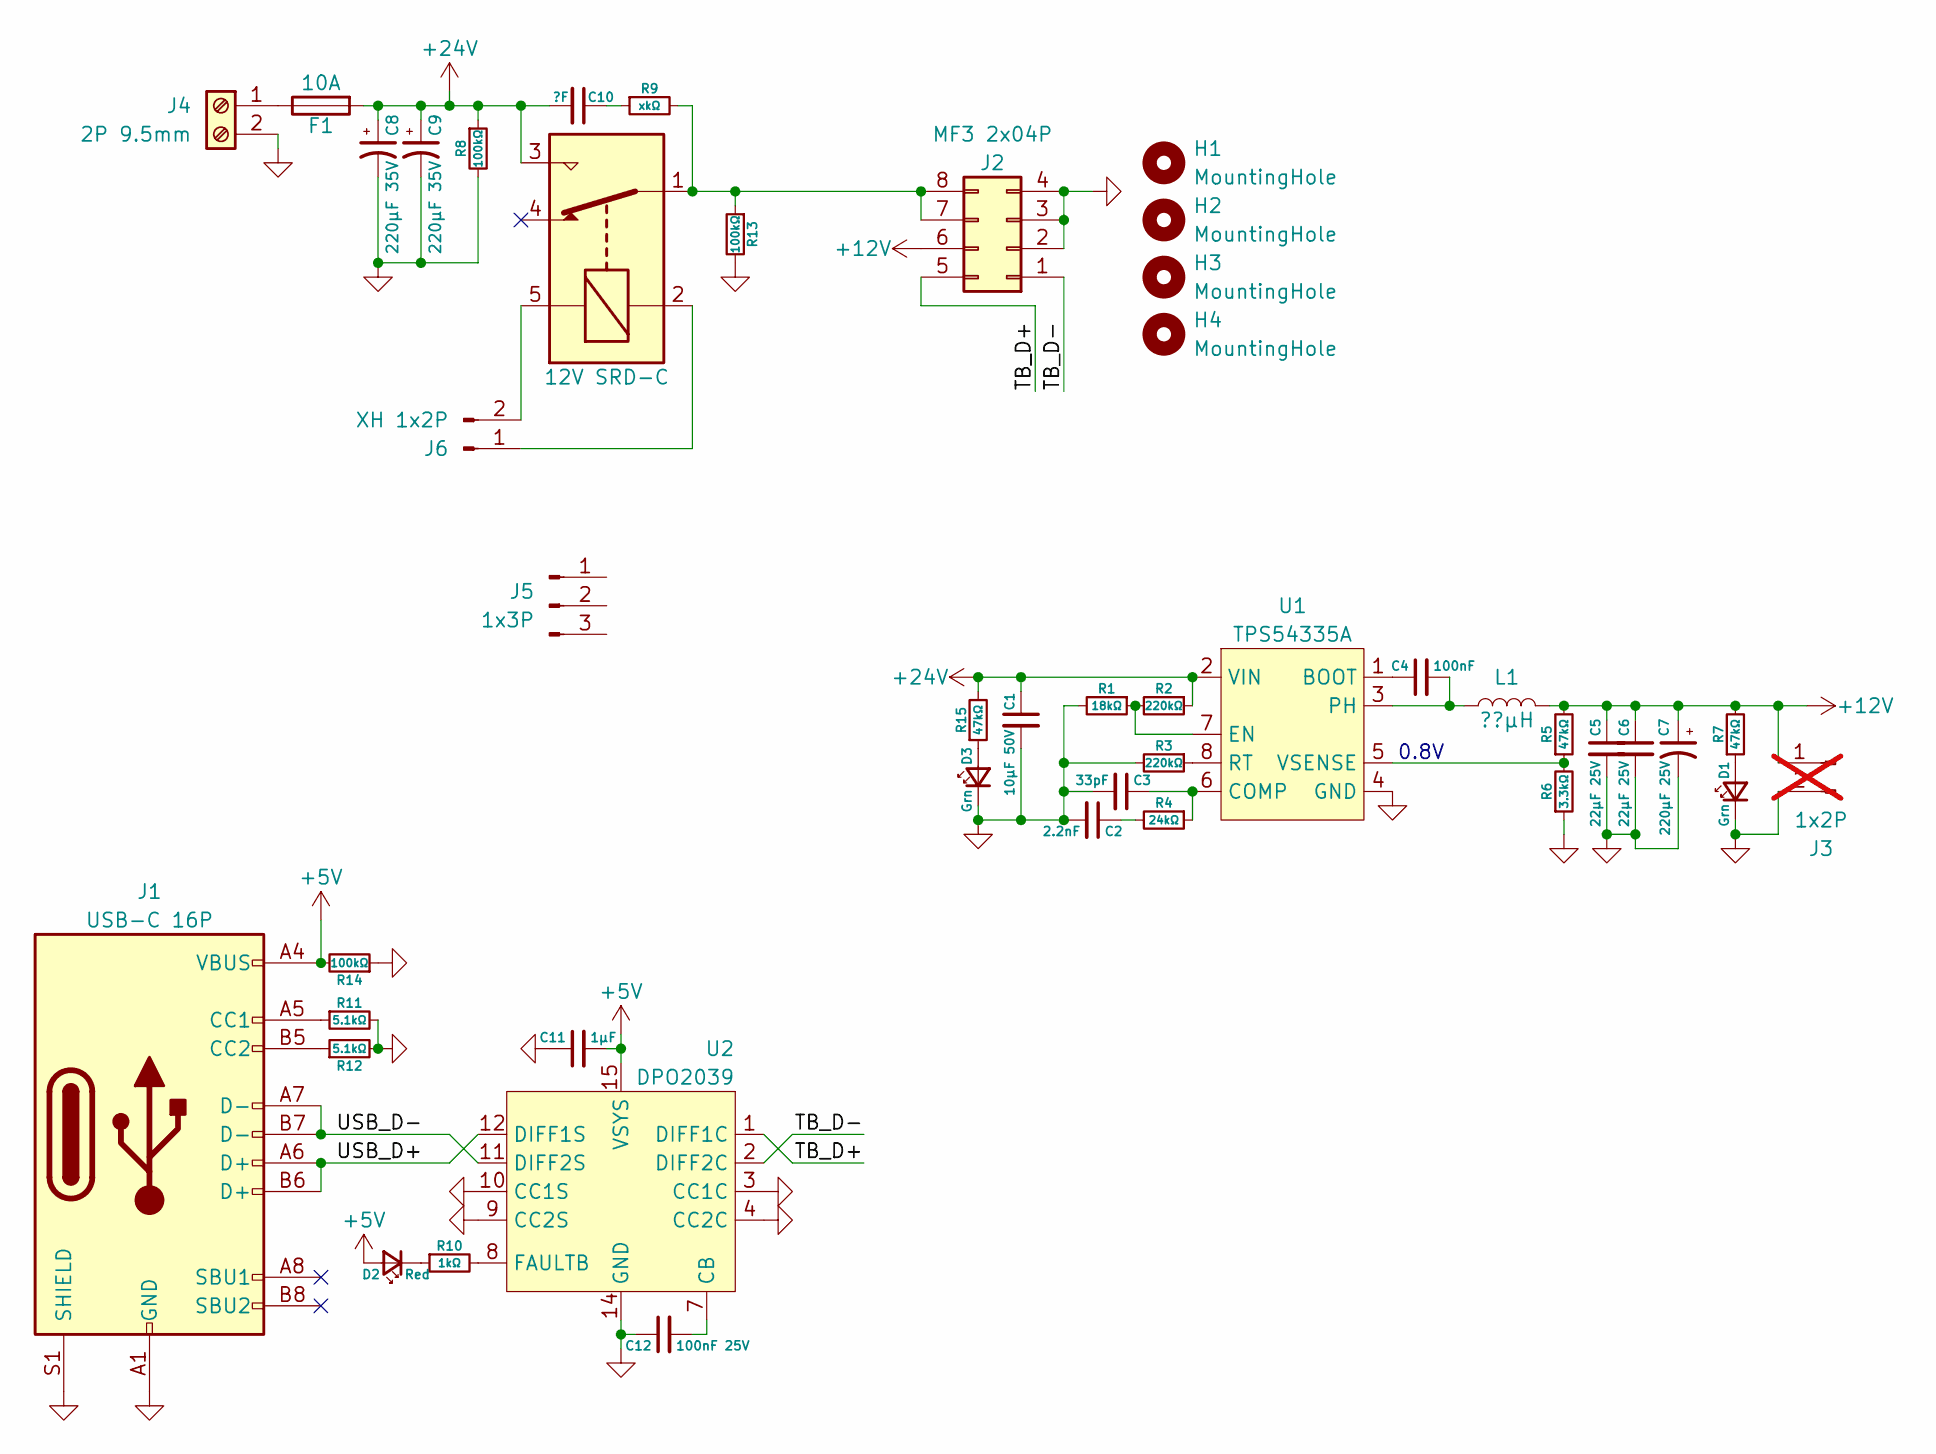
[picture p35: schematic toolboard-bridge.kicad_sch, Corevus Toolboard Bridge]

Parts:
C1: 10μF 50V; C_1206_3216Metric
C2: 2.2nF; 0402C
C3: 33pF; 0402C
C4: 100nF; 0402C
C5, C6: 22μF 25V; C_1206_3216Metric
C7: 220μF 25V; CP_Radial_D8.0mm_P3.50mm
C8, C9: 220μF 35V; CP_Radial_D8.0mm_P3.50mm
C10: ?F; C_1206_3216Metric
C11: 1μF; 0402C
C12: 100nF 25V; 0402C
D1, D3: Grn; 0603LED
D2: Red; 0603LED
F1: 10A; XF-506P
H1, H2, H3, H4: MountingHole; MountingHole_3.2mm_M3_DIN965
J1: USB-C 16P; USB_Type-C_16p
J2: MF3 2x04P; Molex_Micro-Fit-3.0_430450813
J3: 1x2P; PinHeader_1x02_P2.54mm_Vertical; not fitted
J4: 2P 9.5mm; Kefa_KF8500-8.5-2P
J5: 1x3P; PinHeader_1x03_P2.54mm_Vertical
J6: XH 1x2P; JST_XH_1x02
K1: 12V SRD-C; Relay_SPDT_SANYOU_SRD_Series_Form_C
L1: ??μH; L_Changjiang_FXL0640
R1: 18kΩ; 0402R
R2, R3: 220kΩ; 0402R
R4: 24kΩ; 0402R
R5: 47kΩ; 0603R
R6: 3.3kΩ; 0603R
R7, R15: 47kΩ; 0402R
R8, R13, R14: 100kΩ; 0402R
R9: xkΩ; 0402R
R10: 1kΩ; 0402R
R11, R12: 5.1kΩ; 0402R
U1: TPS54335A; SOIC-8-1EP_3.9x4.9mm_P1.27mm_EP2.95x4.9mm_Mask2.71x3.4mm_Th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
U2: DPO2039; VQFN-16-1EP_3x3mm_P0.5mm_EP1.6x1.6mm

Connections:
+5V: C11.2, D2.2 (A), J1.A4 (VBUS), J1.A9 (VBUS), J1.B4 (VBUS), J1.B9 (VBUS), R14.2, U2.15 (VSYS)
+12V: C5.1, C6.1, C7.1, J2.6, J3.1, L1.2, R5.2, R7.2
+24V: C1.1, C8.1, C9.1, C10.2, F1.2, K1.3, R2.1, R8.1, R15.2, U1.2 (VIN)
/TB_D+: J2.5, U2.1 (DIFF1C)
/TB_D-: J2.1, U2.2 (DIFF2C)
/USB_D+: J1.A6 (D+), J1.B6 (D+), U2.12 (DIFF1S)
/USB_D-: J1.A7 (D-), J1.B7 (D-), U2.11 (DIFF2S)
GND: C1.2, C2.2, C3.2, C5.2, C6.2, C7.2, C8.2, C9.2, C11.1, C12.1, D1.1 (K), D3.1 (K), J1.A1 (GND), J1.A12 (GND), J1.B1 (GND), J1.B12 (GND), J1.S1 (SHIELD), J2.2, J2.3, J2.4, J3.2, J4.2, R1.2, R3.2, R6.1, R8.2, R11.2, R12.2, R13.2, R14.1, U1.4 (GND), U1.9 (GND), U2.3 (CC1C), U2.4 (CC2C), U2.5 (NC), U2.6 (NC), U2.9 (CC2S), U2.10 (CC1S), U2.13 (NC), U2.14 (GND), U2.16 (NC), U2.17 (GND)
unnamed: C2.1, R4.2
unnamed: C10.1, R9.1
unnamed: D1.2 (A), R7.1
unnamed: D2.1 (K), R10.1
unnamed: D3.2 (A), R15.1
unnamed: J1.A5 (CC1), R11.1
unnamed: J1.B5 (CC2), R12.1
unnamed: J2.7, J2.8, K1.1, R9.2, R13.1
unnamed: F1.1, J4.1
unnamed: J6.1, K1.2
unnamed: J6.2, K1.5
unnamed: C4.1, U1.1 (BOOT)
unnamed: C3.1, R4.1, U1.6 (COMP)
unnamed: R1.1, R2.2, U1.7 (EN)
unnamed: C4.2, L1.1, U1.3 (PH)
unnamed: R3.1, U1.8 (RT)
unnamed: R5.1, R6.2, U1.5 (VSENSE)
unnamed: C12.2, U2.7 (CB)
unnamed: R10.2, U2.8 (FAULTB)

Notes on the sheet:
0.8V

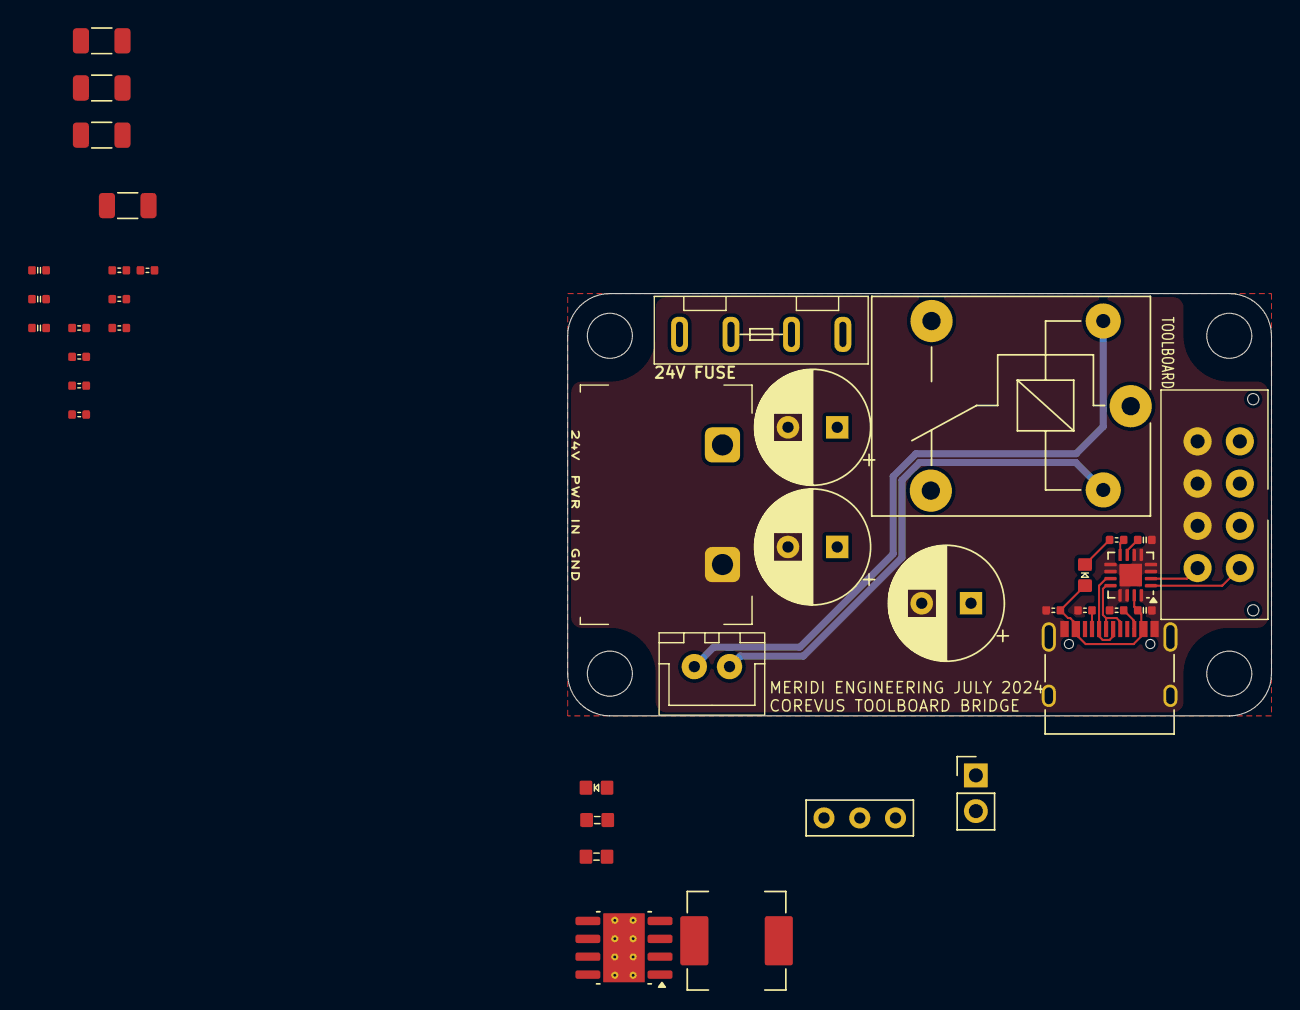
[picture p36: board toolboard-bridge.kicad_pcb from above]

Board: 2 copper layers, 50.0 x 30.0 mm, 43 parts (0 on the bottom side), 26 nets.
