calithameridi/corevus/hardware/motor_drivers/driver-tmc2160/driver-tmc2160.kicad_pcb

## KiCad design hardware/motor_drivers/driver-tmc2160/driver-tmc2160.kicad_pcb (2024-05-26)

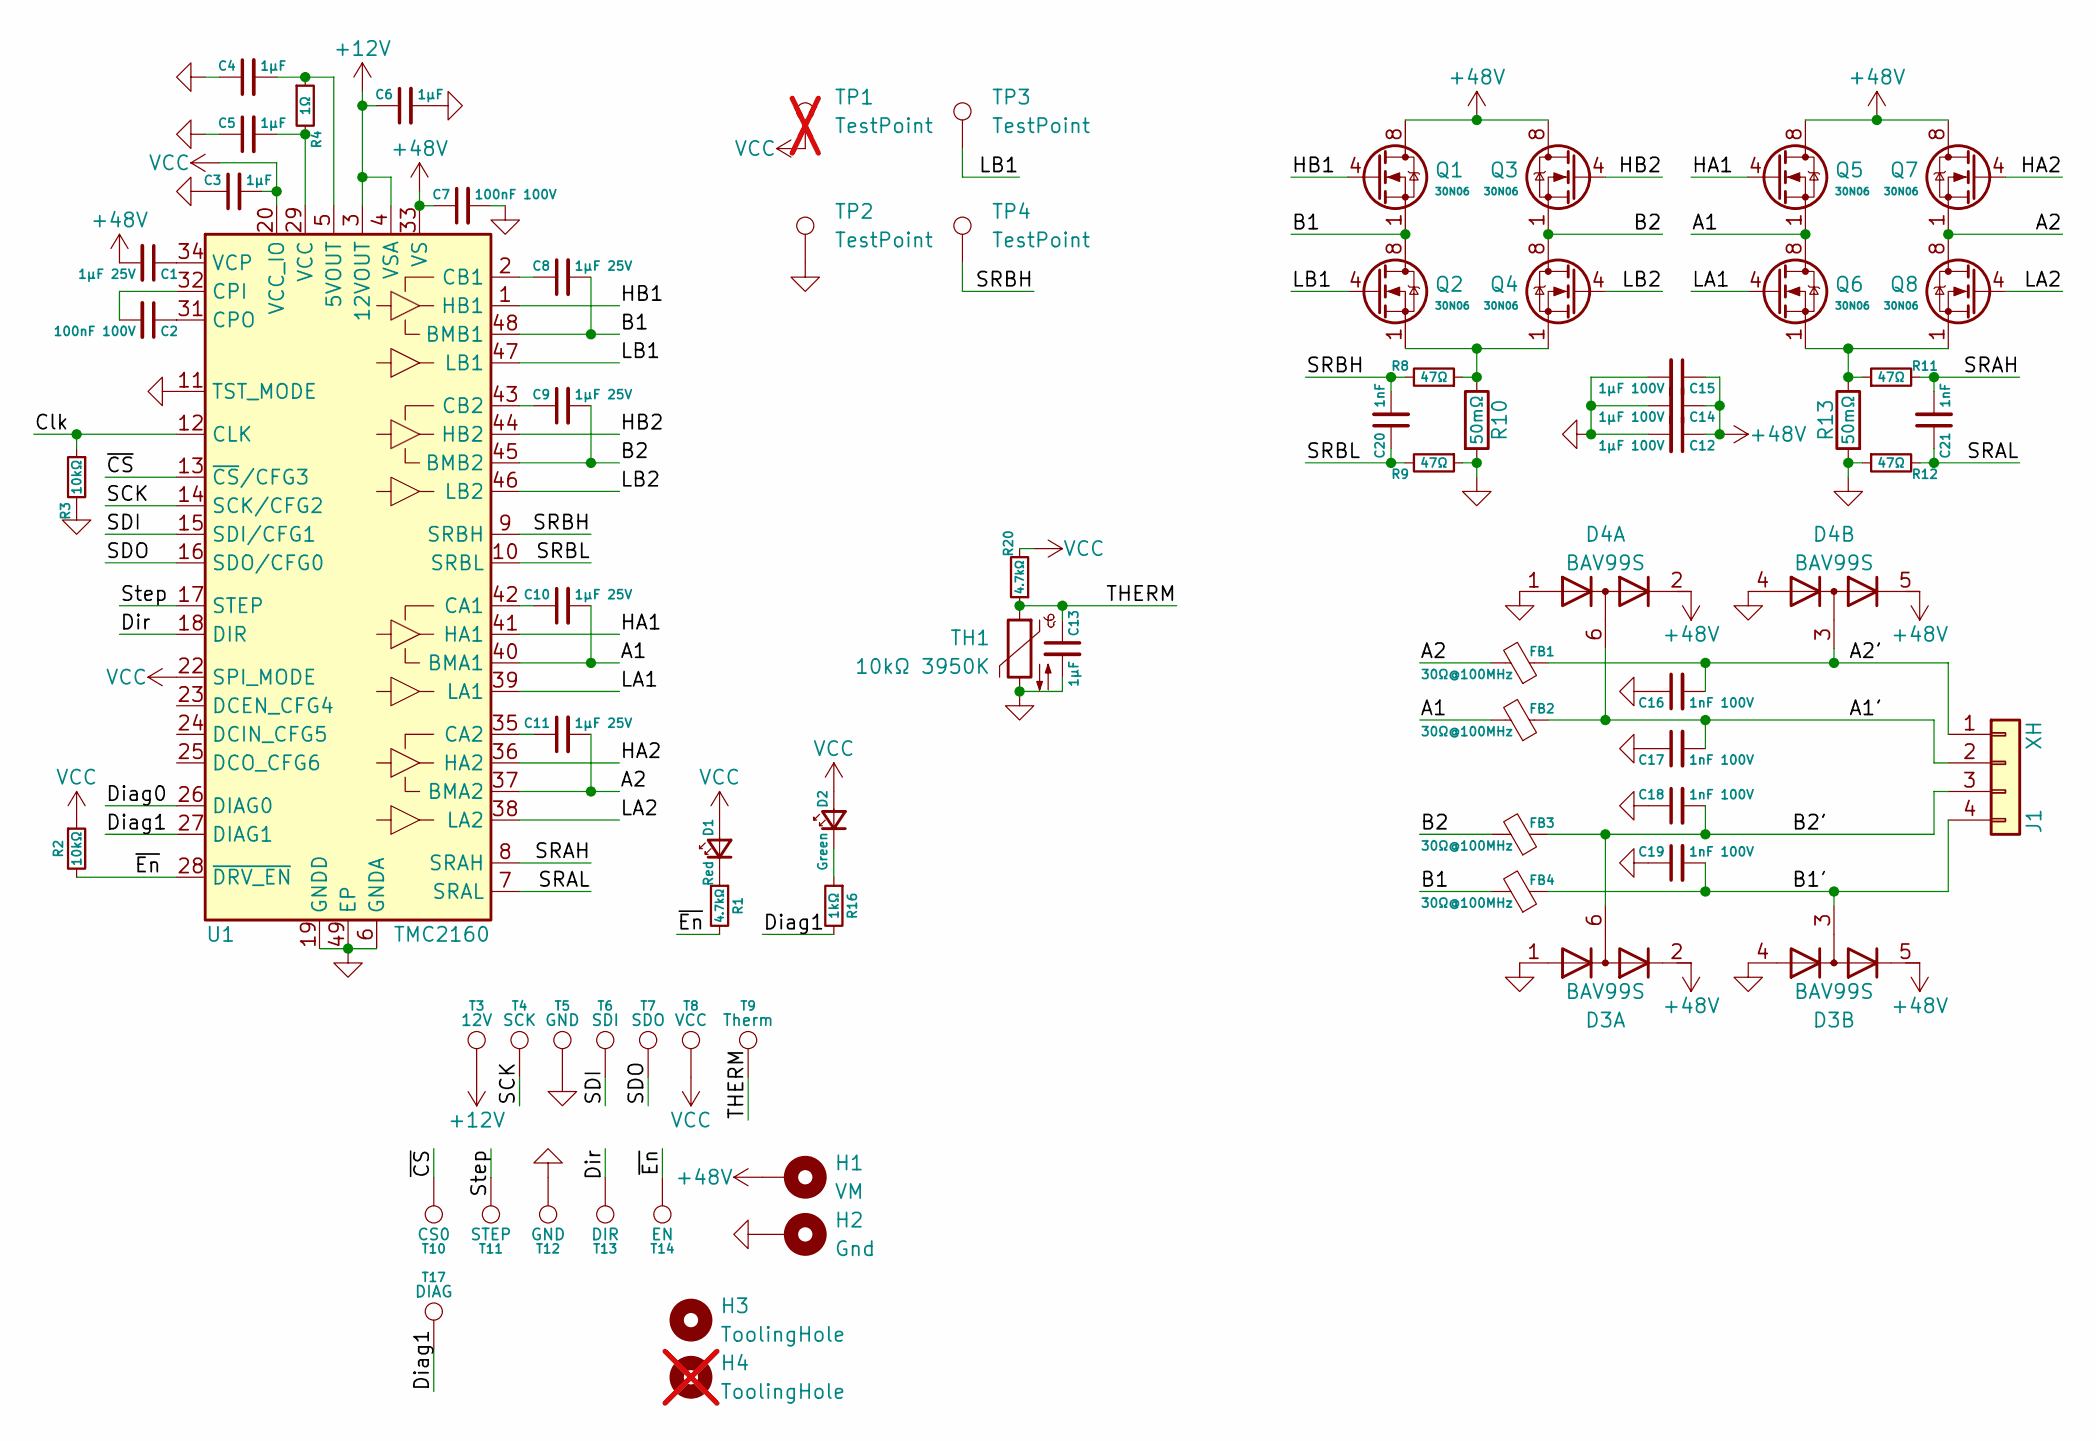
[picture p37: schematic driver-tmc2160.kicad_sch, TMC2160 Stepper Driver Module]

Parts:
C1, C8, C9, C10, C11: 1μF 25V; 0402C
C2, C7: 100nF 100V; 0402C
C3, C5: 1µF; 0402C
C4, C6, C13: 1μF; 0402C
C12, C14, C15: 1μF 100V; C_1206_3216Metric
C16, C17, C18, C19: 1nF 100V; 0402C
C20, C21: 1nF; 0402C
D1: Red; 0402LED
D2: Green; 0402LED
D3, D4: BAV99S; SOT-363_SC-70-6
FB1, FB2, FB3, FB4: 30Ω@100MHz; R_0805_2012Metric
H1: VM; MountingHole_M3_Driver
H2: Gnd; MountingHole_M3_Driver
H3: ToolingHole
H4: ToolingHole; not fitted
J1: XH; XH_1x04_SMD_Vertical
Q1, Q2, Q3, Q4, Q5, Q6, Q7, Q8: 30N06; MOSFET_DFN8
R1, R20: 4.7kΩ; 0402R
R2, R3: 10kΩ; 0402R
R4: 1Ω; 0402R
R8, R9, R11, R12: 47Ω; 0402R
R10, R13: 50mΩ; R_1206_3216Metric
R16: 1kΩ; 0402R
T3: 12V; LGA_Land_2.5mm
T4: SCK; LGA_Land_2.5mm
T5, T12: GND; LGA_Land_2.5mm
T6: SDI; LGA_Land_2.5mm
T7: SDO; LGA_Land_2.5mm
T8: VCC; LGA_Land_2.5mm
T9: Therm; LGA_Land_2.5mm
T10: CS0; LGA_Land_2.5mm
T11: STEP; LGA_Land_2.5mm
T13: DIR; LGA_Land_2.5mm
T14: EN; LGA_Land_2.5mm
T17: DIAG; LGA_Land_2.5mm
TH1: 10kΩ 3950K; 0402R
TP1: TestPoint; TestPoint_Pad_D1.0mm; not fitted
TP2, TP3, TP4: TestPoint; TestPoint_Pad_D1.0mm
U1: TMC2160; TMCx160

Connections:
+12V: C6.1, T3.1, U1.3 (12VOUT), U1.4 (VSA)
+48V: C1.2, C7.1, C12.1, C14.1, C15.1, D3.2 (K2), D3.5 (K4), D4.2 (K2), D4.5 (K4), H1.1, Q1.5 (D), Q1.6 (D), Q1.7 (D), Q1.8 (D), Q3.5 (D), Q3.6 (D), Q3.7 (D), Q3.8 (D), Q5.5 (D), Q5.6 (D), Q5.7 (D), Q5.8 (D), Q7.5 (D), Q7.6 (D), Q7.7 (D), Q7.8 (D), U1.33 (VS)
/A1: C10.2, FB2.2, Q5.1 (S), Q5.2 (S), Q5.3 (S), Q6.5 (D), Q6.6 (D), Q6.7 (D), Q6.8 (D), U1.40 (BMA1)
/A1': C17.2, D4.6 (K3A4), FB2.1, J1.2
/A2: C11.2, FB1.2, Q7.1 (S), Q7.2 (S), Q7.3 (S), Q8.5 (D), Q8.6 (D), Q8.7 (D), Q8.8 (D), U1.37 (BMA2)
/A2': C16.2, D4.3 (K1A2), FB1.1, J1.1
/B1: C8.2, FB4.2, Q1.1 (S), Q1.2 (S), Q1.3 (S), Q2.5 (D), Q2.6 (D), Q2.7 (D), Q2.8 (D), U1.48 (BMB1)
/B1': C19.2, D3.3 (K1A2), FB4.1, J1.4
/B2: C9.2, FB3.2, Q3.1 (S), Q3.2 (S), Q3.3 (S), Q4.5 (D), Q4.6 (D), Q4.7 (D), Q4.8 (D), U1.45 (BMB2)
/B2': C18.2, D3.6 (K3A4), FB3.1, J1.3
/Clk: R3.1, U1.12 (CLK)
/Diag0: U1.26 (DIAG0)
/Diag1: R16.2, T17.1, U1.27 (DIAG1)
/Dir: T13.1, U1.18 (DIR)
/HA1: Q5.4 (G), U1.41 (HA1)
/HA2: Q7.4 (G), U1.36 (HA2)
/HB1: Q1.4 (G), U1.1 (HB1)
/HB2: Q3.4 (G), U1.44 (HB2)
/LA1: Q6.4 (G), U1.39 (LA1)
/LA2: Q8.4 (G), U1.38 (LA2)
/LB1: Q2.4 (G), TP3.1, U1.47 (LB1)
/LB2: Q4.4 (G), U1.46 (LB2)
/SCK: T4.1, U1.14 (SCK/CFG2)
/SDI: T6.1, U1.15 (SDI/CFG1)
/SDO: T7.1, U1.16 (SDO/CFG0)
/SRAH: C21.2, R11.2, U1.8 (SRAH)
/SRAL: C21.1, R12.2, U1.7 (SRAL)
/SRBH: C20.2, R8.2, TP4.1, U1.9 (SRBH)
/SRBL: C20.1, R9.2, U1.10 (SRBL)
/Step: T11.1, U1.17 (STEP)
/THERM: C13.1, R20.1, T9.1, TH1.1
/~CS: T10.1, U1.13 (~CS/CFG3)
/~En: R1.2, R2.2, T14.1, U1.28 (~DRV_EN)
GND: C3.1, C4.1, C5.1, C6.2, C7.2, C12.2, C13.2, C14.2, C15.2, C16.1, C17.1, C18.1, C19.1, D3.1 (A1), D3.4 (A3), D4.1 (A1), D4.4 (A3), H2.1, R3.2, R9.1, R10.2, R12.1, R13.2, T5.1, T12.1, TH1.2, TP2.1, U1.6 (GNDA), U1.11 (TST_MODE), U1.19 (GNDD), U1.30 (GNDD), U1.49 (EP)
unnamed: D1.1 (K), R1.1
unnamed: D2.1 (K), R16.1
unnamed: Q2.1 (S), Q2.2 (S), Q2.3 (S), Q4.1 (S), Q4.2 (S), Q4.3 (S), R8.1, R10.1
unnamed: Q6.1 (S), Q6.2 (S), Q6.3 (S), Q8.1 (S), Q8.2 (S), Q8.3 (S), R11.1, R13.1
unnamed: C4.2, R4.1, U1.5 (5VOUT)
unnamed: C10.1, U1.42 (CA1)
unnamed: C11.1, U1.35 (CA2)
unnamed: C8.1, U1.2 (CB1)
unnamed: C9.1, U1.43 (CB2)
unnamed: C2.2, U1.32 (CPI)
unnamed: C2.1, U1.31 (CPO)
unnamed: C5.2, R4.2, U1.29 (VCC)
unnamed: C1.1, U1.34 (VCP)
VCC: C3.2, D1.2 (A), D2.2 (A), R2.1, R20.2, T8.1, U1.20 (VCC_IO), U1.21 (VCC_IO), U1.22 (SPI_MODE)

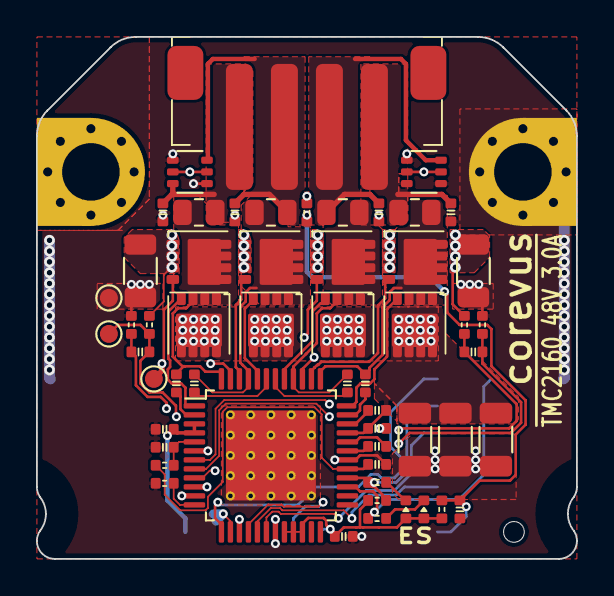
[picture p38: board driver-tmc2160.kicad_pcb from above]

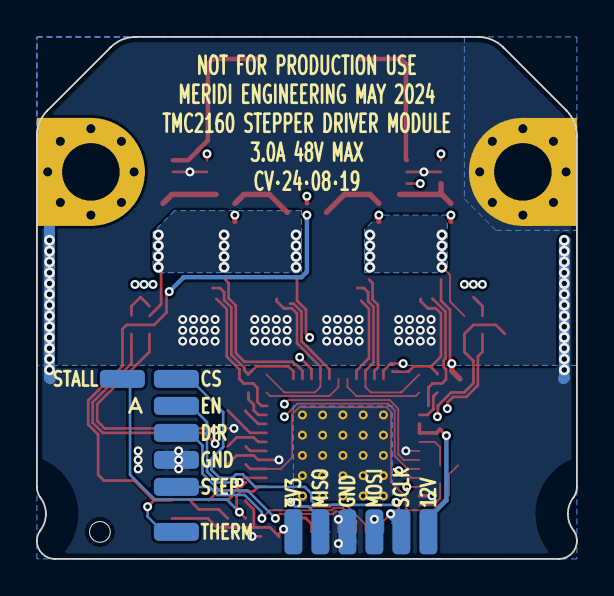
[picture p39: board driver-tmc2160.kicad_pcb from below]

Board: 4 copper layers, 30.0 x 29.0 mm, 71 parts (13 on the bottom side), 47 nets.
