calithameridi/corevus/hardware/corevus-m++/corevus-m++.kicad_pcb

## KiCad design hardware/corevus-m++/corevus-m++.kicad_pcb (2024-05-26)

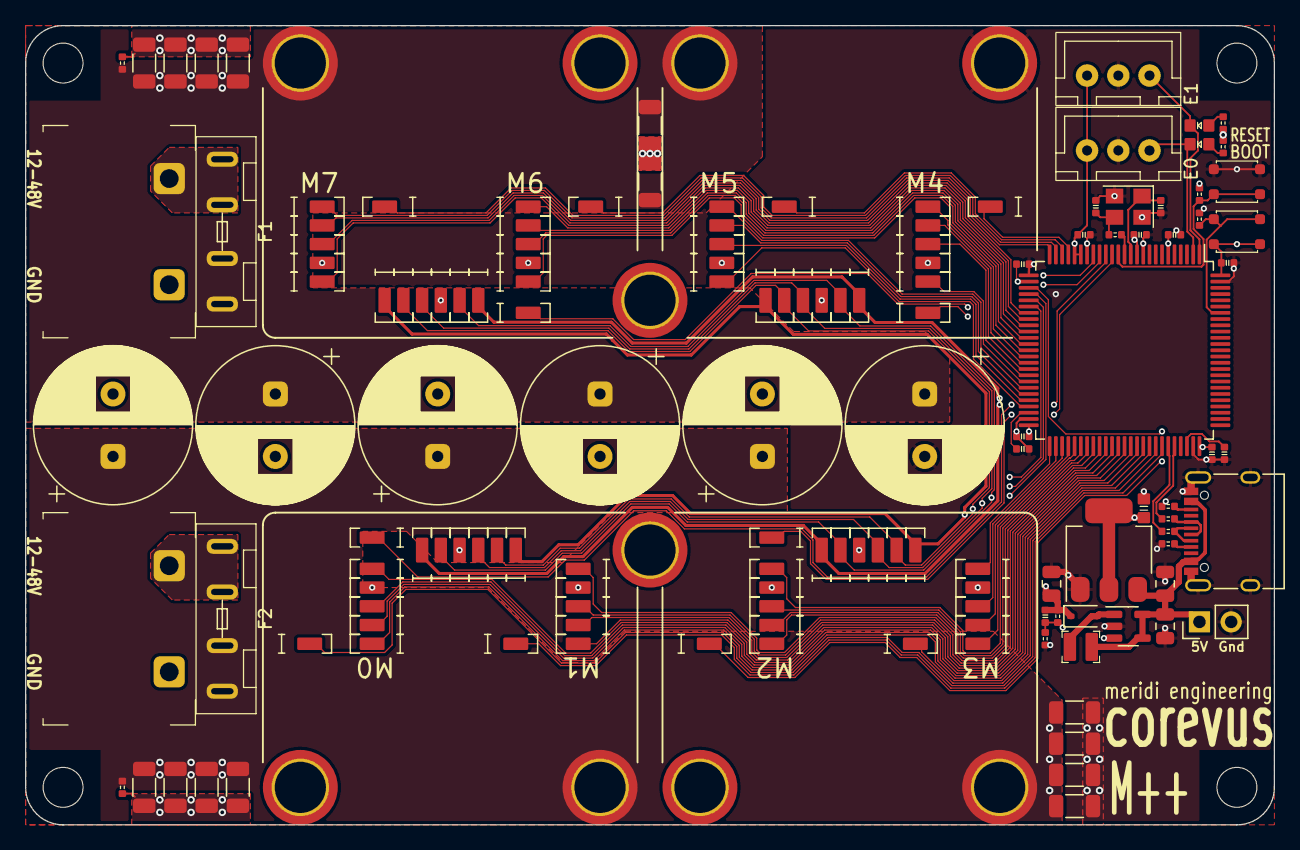
[picture p40: board corevus-m++.kicad_pcb from above]

Board: 4 copper layers, 100.0 x 64.0 mm, 157 parts (0 on the bottom side), 74 nets.

Parts:
C1, C2, C7: 10μF; C_0805_2012Metric
C3, C4: 16pF; 0402C
C5: 10μF; 0603C
C6: 4.7pF; 0402C
C8, C9, C10, C33, C34, C35, C36, C37, C38: 1µF; 0402C
C11, C12, C13, C14, C15, C16: 390μF 63V; CP_Radial_D12.5mm_P5.00mm
C17, C19, C20, C21, C23, C24, C25, C26, C27, C28, C29, C30, C31, C32: 1μF 63V; C_1206_3216Metric
D1, D2: Red; 0603LED
D3: 5819; D_SOD-323
F1, F2: 10A; XF-506P
H1, H2, H3, H4: MountingHole; MountingHole_3.2mm_M3
H5, H6: Back; M3_M2.5_PCB_Nut
H7, H9, H11, H13: V_{M}; M3_M2.5_PCB_Nut
H8, H10, H12, H14: Gnd; M3_M2.5_PCB_Nut
J1, J2: XH; JST_XH_1x03
J3: USB 2.0; USB_Type-C_16p
J4, J5: Power In; Kefa_KF8500-8.5-2P
J6: 1x2P; PinHeader_1x02_P2.54mm_Vertical
L1: 10µH; L_Changjiang_FTC2520
R1, R2: 2.2kΩ; 0402R
R3, R5, R6: 10kΩ; 0402R
R4: 100kΩ; 0402R
R7, R8: 33Ω; 0402R
R9, R10: 5.1kΩ; 0402R
R11: 1kΩ; 0402R
R12, R13: 200kΩ; 0402R
SW1: RST; ShouHan_TS3315A
SW2: BOOT; ShouHan_TS3315A
T1, T8, T15, T22: V_{SA}; LGA_Spring
T2, T9, T16, T23: SClk; LGA_Spring
T3, T10, T17, T24: MOSI; LGA_Spring
T4, T11, T18, T25, T53, T54, T55, T56, T57, T58, T59, T60: Gnd; LGA_Spring
T5, T12, T19, T26: MISO; LGA_Spring
T6, T13, T20, T27: 3.3V; LGA_Spring
T7, T14, T21, T28: Therm; LGA_Spring
T29, T30, T31, T32, T33, T34, T35, T36: CS; LGA_Spring
T37, T38, T39, T40, T41, T42, T43, T44: En; LGA_Spring
T45, T46, T47, T48, T49, T50, T51, T52: Dir; LGA_Spring
T61, T62, T63, T64, T65, T66, T67, T68: Step; LGA_Spring
T69, T70, T71, T72, T73, T74, T75, T76: Stall; LGA_Spring
U1: AMS1117-3.3; SOT-223-3_TabPin2
U2: TPS61040DBV; SOT-23-5
U3: STM32H750VBTx; LQFP-100_14x14mm_P0.5mm
Y1: 25 MHz; Crystal_SMD_3225-4Pin_3.2x2.5mm

Connections:
+3.3V: C5.1, C8.1, C9.1, C10.1, C33.1, C34.1, C35.1, C38.1, J1.3, J2.3, R1.2, R2.2, R5.2, SW2.2, T6.1, T13.1, T20.1, T27.1, U1.2 (VO), U3.6 (VBAT), U3.11 (VDD), U3.20 (VREF+), U3.21 (VDDA), U3.27 (VDD), U3.50 (VDD), U3.75 (VDD), U3.100 (VDD)
+5V: C1.1, C2.1, J3.A4 (VBUS), J3.A9 (VBUS), J3.B4 (VBUS), J3.B9 (VBUS), J6.1, L1.1, U1.3 (VI), U2.4 (EN), U2.5 (VIN)
+12V: C6.2, C7.1, D3.1 (K), R4.1, T1.1, T8.1, T15.1, T22.1
/BOOT0: R6.1, SW2.1, U3.94 (BOOT0)
/E0: D1.1 (K), J1.1, U3.1 (PE2)
/E1: D2.1 (K), J2.1, U3.2 (PE3)
/MISO: T5.1, T12.1, T19.1, T26.1
/MOSI: T3.1, T10.1, T17.1, T24.1
/NRST: R5.1, SW1.2, U3.14 (NRST)
/SCK: T2.1, T9.1, T16.1, T23.1
/_{M0}Dir: T52.1, U3.64 (PC7)
/_{M0}Stall: T76.1, U3.68 (PA9)
/_{M0}Step: T68.1, U3.63 (PC6)
/_{M0}Th: T28.1, U3.16 (PC1)
/_{M0}~CS: T36.1, U3.66 (PC9)
/_{M0}~En: T44.1, U3.65 (PC8)
/_{M1}Dir: T51.1, U3.60 (PD13)
/_{M1}Stall: T75.1, U3.69 (PA10)
/_{M1}Step: T67.1, U3.59 (PD12)
/_{M1}~CS: T35.1, U3.62 (PD15)
/_{M1}~En: T43.1, U3.61 (PD14)
/_{M2}Dir: T50.1, U3.56 (PD9)
/_{M2}Stall: T74.1, U3.28 (PA4)
/_{M2}Step: T66.1, U3.55 (PD8)
/_{M2}Th: T21.1, U3.15 (PC0)
/_{M2}~CS: T34.1, U3.58 (PD11)
/_{M2}~En: T42.1, U3.57 (PD10)
/_{M3}Dir: T49.1, U3.52 (PB13)
/_{M3}Stall: T73.1, U3.67 (PA8)
/_{M3}Step: T65.1, U3.51 (PB12)
/_{M3}~CS: T33.1, U3.54 (PB15)
/_{M3}~En: T41.1, U3.53 (PB14)
/_{M4}Dir: T48.1, U3.42 (PE12)
/_{M4}Stall: T72.1, U3.22 (PA0)
/_{M4}Step: T64.1, U3.43 (PE13)
/_{M4}Th: T14.1, U3.17 (PC2_C)
/_{M4}~CS: T32.1, U3.40 (PE10)
/_{M4}~En: T40.1, U3.41 (PE11)
/_{M5}Dir: T47.1, U3.46 (PB10)
/_{M5}Stall: T71.1, U3.23 (PA1)
/_{M5}Step: T63.1, U3.47 (PB11)
/_{M5}~CS: T31.1, U3.44 (PE14)
/_{M5}~En: T39.1, U3.45 (PE15)
/_{M6}Dir: T46.1, U3.38 (PE8)
/_{M6}Stall: T70.1, U3.24 (PA2)
/_{M6}Step: T62.1, U3.39 (PE9)
/_{M6}Th: T7.1, U3.18 (PC3_C)
/_{M6}~CS: T30.1, U3.36 (PB2)
/_{M6}~En: T38.1, U3.37 (PE7)
/_{M7}Dir: T45.1, U3.34 (PB0)
/_{M7}Stall: T69.1, U3.25 (PA3)
/_{M7}Step: T61.1, U3.35 (PB1)
/_{M7}~CS: T29.1, U3.32 (PC4)
/_{M7}~En: T37.1, U3.33 (PC5)
GND: C1.2, C2.2, C3.1, C4.1, C5.2, C7.2, C8.2, C9.2, C10.2, C11.2, C12.2, C13.2, C14.2, C15.2, C16.2, C17.2, C19.2, C20.2, C21.2, C23.2, C24.2, C25.2, C26.2, C27.2, C28.2, C29.2, C30.2, C31.2, C32.2, C33.2, C34.2, C35.2, C36.1, C37.1, C38.2, H8.1, H10.1, H12.1, H14.1, J1.2, J2.2, J3.A1 (GND), J3.A12 (GND), J3.B1 (GND), J3.B12 (GND), J3.S1 (SHIELD), J4.2, J5.2, J6.2, R3.1, R6.2, R9.1, R10.1, R12.1, R13.1, SW1.1, T4.1, T11.1, T18.1, T25.1, T53.1, T54.1, T55.1, T56.1, T57.1, T58.1, T59.1, T60.1, U1.1 (GND), U2.2 (GND), U3.10 (VSS), U3.19 (VSSA), U3.26 (VSS), U3.49 (VSS), U3.74 (VSS), U3.99 (VSS), Y1.2, Y1.4
unnamed: C4.2, R11.1, Y1.3
unnamed: C36.2, U3.48 (VCAP)
unnamed: C37.2, U3.73 (VCAP)
unnamed: D1.2 (A), R1.1
unnamed: D2.2 (A), R2.1
unnamed: D3.2 (A), L1.2, U2.1 (SW)
unnamed: J3.A5 (CC1), R9.2
unnamed: J3.B5 (CC2), R10.2
unnamed: J3.A6 (D+), J3.B6 (D+), R8.1
unnamed: J3.A7 (D-), J3.B7 (D-), R7.1
unnamed: F1.1, J4.1
unnamed: F2.1, J5.1
unnamed: C6.1, R3.2, R4.2, U2.3 (FB)
unnamed: R7.2, U3.70 (PA11)
unnamed: R8.2, U3.71 (PA12)
unnamed: C3.2, U3.12 (PH0), Y1.1
unnamed: R11.2, U3.13 (PH1)
VMA: C11.1, C12.1, C13.1, C19.1, C20.1, C23.1, C24.1, C27.1, C28.1, C31.1, C32.1, F2.2, H11.1, H13.1, R13.2
VMB: C14.1, C15.1, C16.1, C17.1, C21.1, C25.1, C26.1, C29.1, C30.1, F1.2, H7.1, H9.1, R12.2
