calithameridi/corevus/hardware/motor_drivers/driver-tmc2209/driver-tmc2209.kicad_pcb

## KiCad design hardware/motor_drivers/driver-tmc2209/driver-tmc2209.kicad_pcb (2024-05-26)

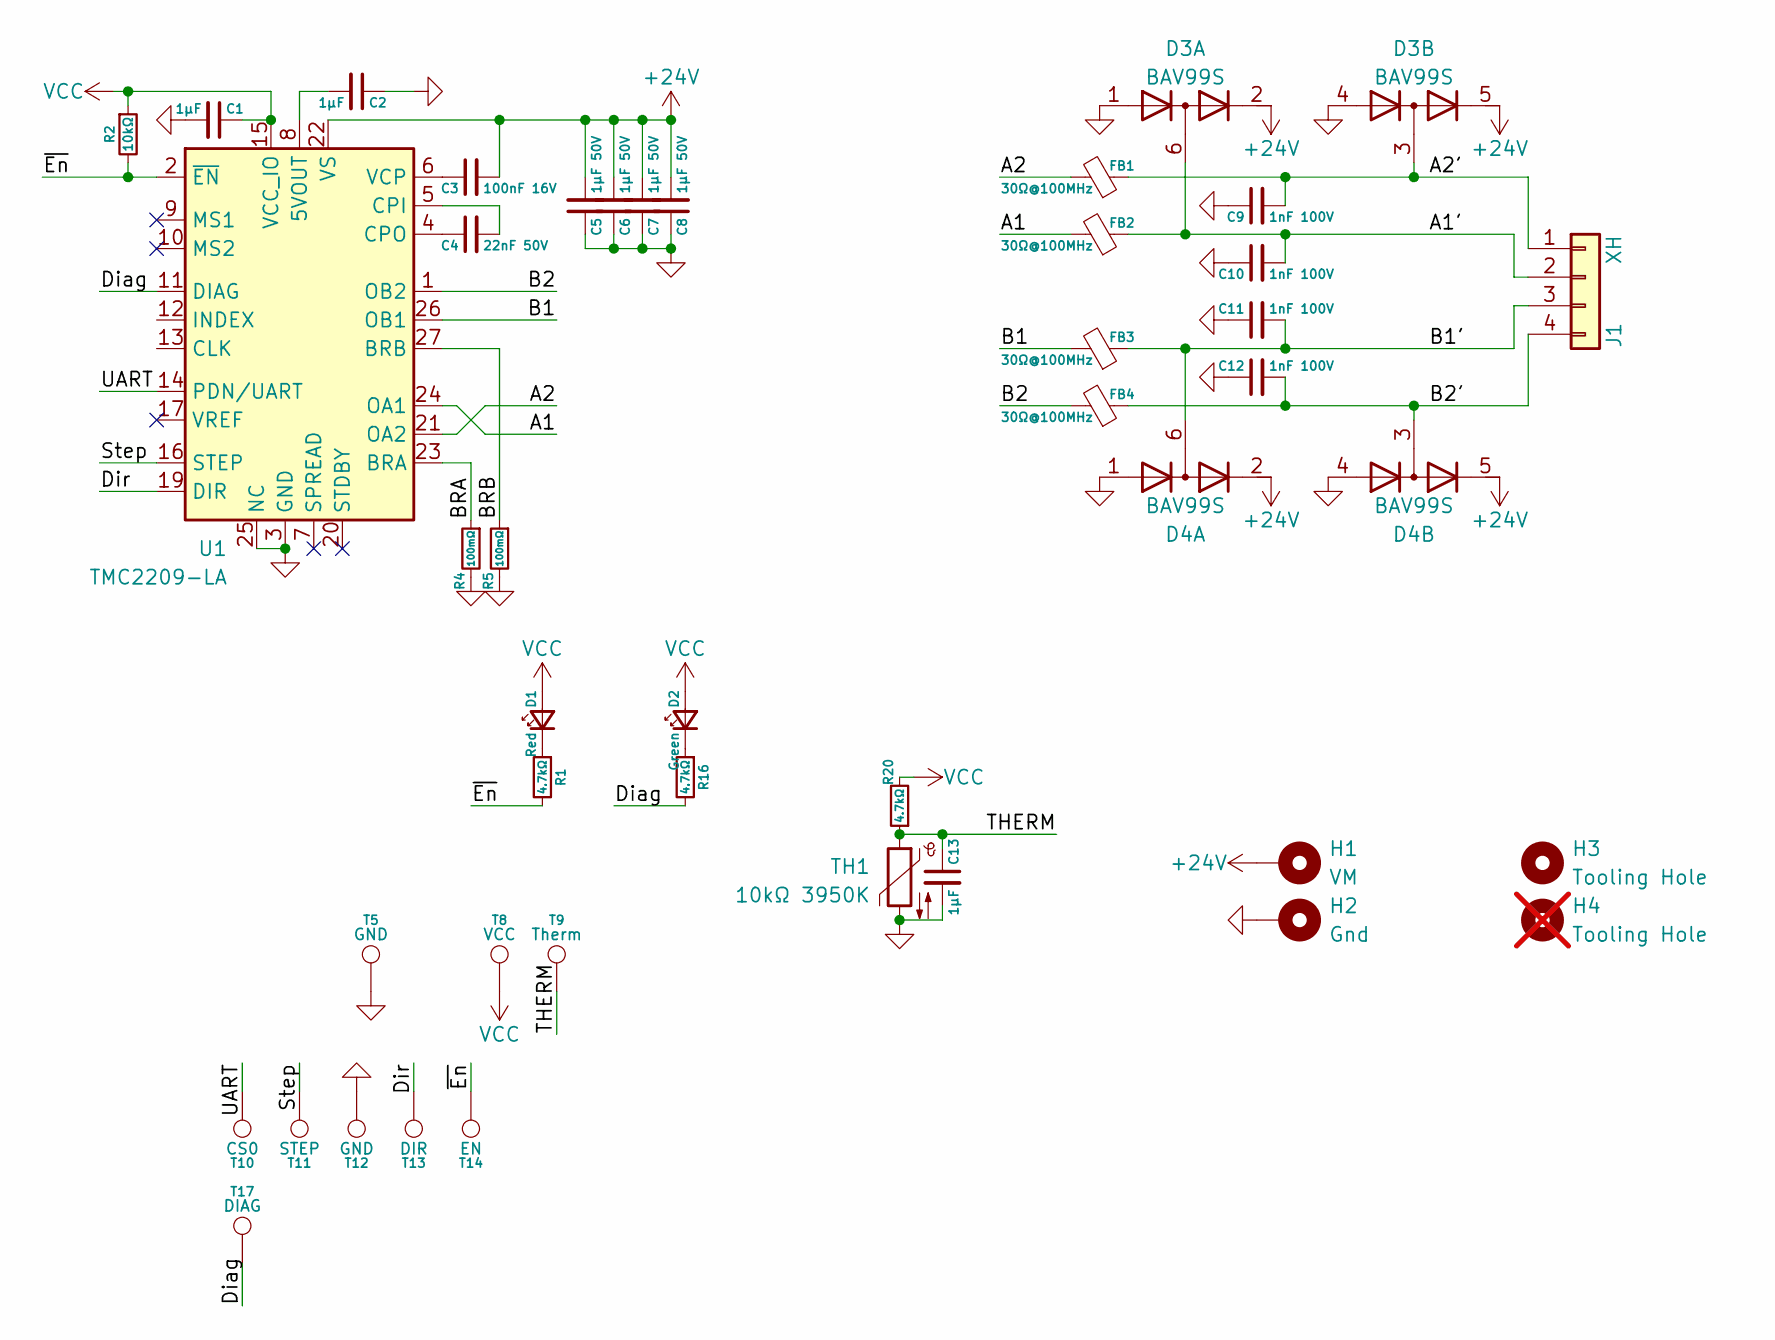
[picture p41: schematic driver-tmc2209.kicad_sch]

Parts:
C1, C2: 1μF; 0402C; LCSC C1525
C3: 100nF 16V; 0402C; LCSC C1525
C4: 22nF 50V; 0402C; LCSC C1532
C5, C6, C7, C8: 1μF 50V; 0603C; LCSC C15849
C9, C10, C11, C12: 1nF 100V; 0402C
C13: 1μF; 0402C
D1: Red; 0402LED
D2: Green; 0402LED
D3, D4: BAV99S; SOT-363_SC-70-6
FB1, FB2, FB3, FB4: 30Ω@100MHz; R_0805_2012Metric
H1: VM; MountingHole_M3_Driver_Corner
H2: Gnd; MountingHole_M3_Driver_Corner
H3: Tooling Hole; ToolingHole
H4: Tooling Hole; ToolingHole; not fitted
J1: XH; XH_1x04_SMD_Vertical
R1, R16, R20: 4.7kΩ; 0402R
R2: 10kΩ; 0402R
R4, R5: 100mΩ; R_0805_2012Metric; LCSC C382279
T5, T12: GND; LGA_Land_2.5mm
T8: VCC; LGA_Land_2.5mm
T9: Therm; LGA_Land_2.5mm
T10: CS0; LGA_Land_2.5mm
T11: STEP; LGA_Land_2.5mm
T13: DIR; LGA_Land_2.5mm
T14: EN; LGA_Land_2.5mm
T17: DIAG; LGA_Land_2.5mm
TH1: 10kΩ 3950K; 0402R
U1: TMC2209-LA; TMC220x

Connections:
+24V: C3.2, C5.2, C6.2, C7.2, C8.2, D3.2 (K2), D3.5 (K4), D4.2 (K2), D4.5 (K4), H1.1, U1.22 (VS), U1.28 (VS)
/A1: FB2.2, U1.24 (OA1)
/A1': C10.2, D3.6 (K3A4), FB2.1, J1.2
/A2: FB1.2, U1.21 (OA2)
/A2': C9.2, D3.3 (K1A2), FB1.1, J1.1
/B1: FB3.2, U1.26 (OB1)
/B1': C11.2, D4.6 (K3A4), FB3.1, J1.3
/B2: FB4.2, U1.1 (OB2)
/B2': C12.2, D4.3 (K1A2), FB4.1, J1.4
/BRA: R4.1, U1.23 (BRA)
/BRB: R5.1, U1.27 (BRB)
/Diag: R16.2, T17.1, U1.11 (DIAG)
/Dir: T13.1, U1.19 (DIR)
/Step: T11.1, U1.16 (STEP)
/THERM: C13.1, R20.1, T9.1, TH1.1
/UART: T10.1, U1.14 (PDN/UART)
/~En: R1.2, R2.2, T14.1, U1.2 (~EN)
GND: C1.2, C2.1, C5.1, C6.1, C7.1, C8.1, C9.1, C10.1, C11.1, C12.1, C13.2, D3.1 (A1), D3.4 (A3), D4.1 (A1), D4.4 (A3), H2.1, R4.2, R5.2, T5.1, T12.1, TH1.2, U1.3 (GND), U1.18 (Gnd), U1.25 (NC), U1.29 (Pad)
unnamed: D1.1 (K), R1.1
unnamed: D2.1 (K), R16.1
unnamed: C2.2, U1.8 (5VOUT)
unnamed: C4.2, U1.5 (CPI)
unnamed: C4.1, U1.4 (CPO)
unnamed: C3.1, U1.6 (VCP)
VCC: C1.1, D1.2 (A), D2.2 (A), R2.1, R20.2, T8.1, U1.15 (VCC_IO)

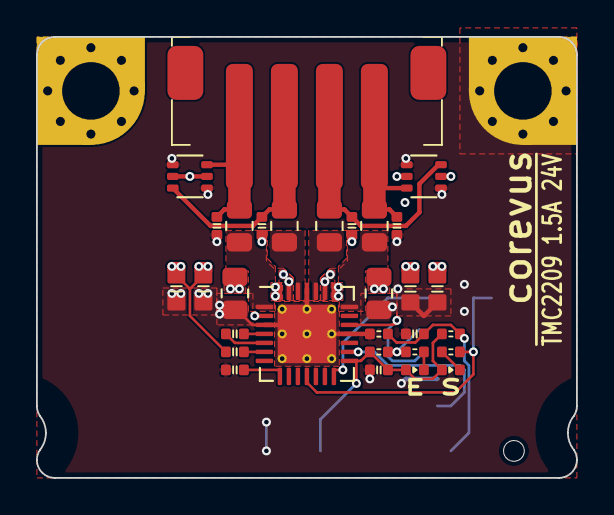
[picture p42: board driver-tmc2209.kicad_pcb from above]

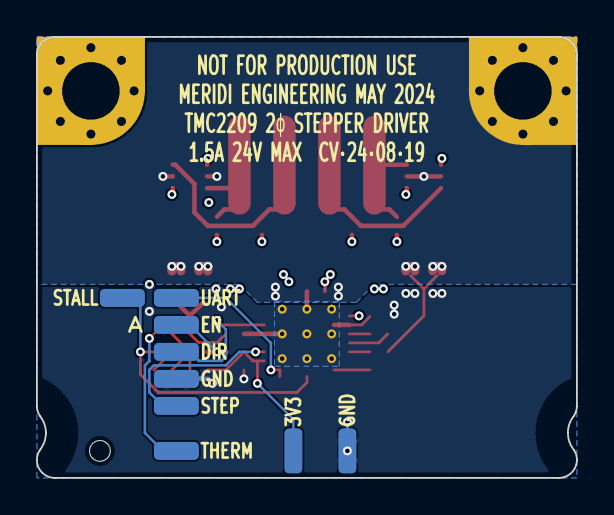
[picture p43: board driver-tmc2209.kicad_pcb from below]

Board: 4 copper layers, 30.0 x 24.5 mm, 42 parts (9 on the bottom side), 25 nets.
