calithameridi/corevus/hardware/corevus-m/corevus-m.kicad_pcb

## KiCad design hardware/corevus-m/corevus-m.kicad_pcb (2023-10-14)

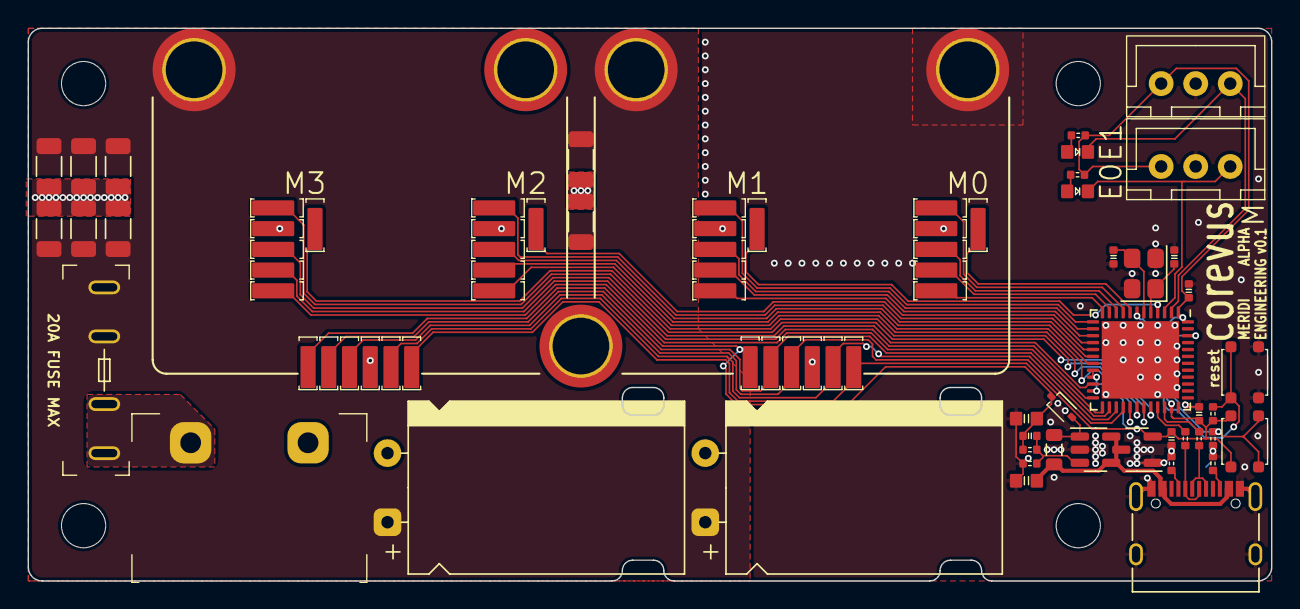
[picture p44: board corevus-m.kicad_pcb from above]

Board: 2 copper layers, 90.0 x 40.0 mm, 88 parts (0 on the bottom side), 45 nets.

Parts:
C1, C2, C3: 1µF; 0402C
C7, C8: 15pF; 0402C
C11, C13: 10μF; 0603C
C12: 4.7pF; 0402C
C14, C15, C16, C17, C18, C19, C20, C21: 1μF 63V; C_1206_3216Metric
C22, C23: 680μF 63V; CP_Radial_D12.5mm_P5.00mm_H20mm_Horizontal
D1: 5819; D_SOD-323
D2, D3: Red; 0603LED
F1: 10A; XF-505P
H1, H3: V_{M}; M3_M2.5_PCB_Nut
H2, H4: Gnd; M3_M2.5_PCB_Nut
H5: Back; M3_M2.5_PCB_Nut
H6, H7, H8, H9: MountingHole; MountingHole_3.2mm_M3
J1: Power In; Kefa_KF8500-8.5-2P
J2: USB 2.0; USB_Type-C_16p
J3, J4: XH; JST_XH_1x03
L1: 10µH; L_0805_2012Metric
R1, R3, R7: 10kΩ; 0402R
R2, R4: 200Ω; 0402R
R8: 100kΩ; 0402R
R9, R10: 33Ω; 0402R
R11, R12: 5.1kΩ; 0402R
SW1: BOOT; ShouHan_TS3315A
SW2: RST; ShouHan_TS3315A
T1, T19: V_{SA}; LGA_Spring
T2, T20: SClk; LGA_Spring
T3, T21: MOSI; LGA_Spring
T4, T10, T16, T22, T28, T34: Gnd; LGA_Spring
T5, T23: MISO; LGA_Spring
T6, T24: 3.3V; LGA_Spring
T7, T13, T25, T31: CS; LGA_Spring
T8, T14, T26, T32: En; LGA_Spring
T9, T15, T27, T33: Dir; LGA_Spring
T11, T17, T29, T35: Step; LGA_Spring
T12, T18, T30, T36: Diag; LGA_Spring
U1: STM32G431CBUx; QFN-48-1EP_7x7mm_P0.5mm_EP5.6x5.6mm
U2: TPS61040DBV; SOT-23-5
U3: XC6206P332MR; SOT-23-3
Y1: 12 MHz; Crystal_SMD_3225-4Pin_3.2x2.5mm

Connections:
+3.3V: C1.1, C2.1, C3.1, J3.3, J4.3, R2.2, R3.1, R4.2, SW1.2, T6.1, T24.1, U1.1 (VBAT), U1.20 (VREF+), U1.21 (VDDA), U1.23 (VDD), U1.35 (VDD), U1.48 (VDD), U3.2 (VO)
+5V: C11.1, J2.A4 (VBUS), J2.A9 (VBUS), J2.B4 (VBUS), J2.B9 (VBUS), L1.1, U2.4 (EN), U2.5 (VIN), U3.3 (VI)
+12V: C12.2, C13.1, D1.1 (K), R8.1, T1.1, T19.1
+48V: C14.1, C15.1, C16.1, C17.1, C18.1, C19.1, C20.1, C21.1, C22.1, C23.1, F1.2, H1.1, H3.1
/BOOT0: R1.2, SW1.1, U1.46 (PB8)
/E0: D2.1 (K), J3.1, U1.2 (PC13)
/E1: D3.1 (K), J4.1, U1.3 (PC14)
/MISO: T5.1, T23.1, U1.27 (PB14)
/MOSI: T3.1, T21.1, U1.28 (PB15)
/SCK: T2.1, T20.1, U1.26 (PB13)
/_{M10}Diag: T12.1, U1.8 (PA0)
/_{M10}Dir: T9.1, U1.10 (PA2)
/_{M10}Step: T11.1, U1.9 (PA1)
/_{M10}~CS: T7.1, U1.12 (PA4)
/_{M10}~En: T8.1, U1.11 (PA3)
/_{M12}Diag: T18.1, U1.4 (PC15)
/_{M12}Dir: T15.1, U1.14 (PA6)
/_{M12}Step: T17.1, U1.13 (PA5)
/_{M12}~CS: T13.1, U1.16 (PC4)
/_{M12}~En: T14.1, U1.15 (PA7)
/_{M20}Diag: T30.1, U1.17 (PB0)
/_{M20}Dir: T27.1, U1.19 (PB2)
/_{M20}Step: T29.1, U1.18 (PB1)
/_{M20}~CS: T25.1, U1.30 (PA8)
/_{M20}~En: T26.1, U1.29 (PC6)
/_{M22}Diag: T36.1, U1.31 (PA9)
/_{M22}Dir: T33.1, U1.22 (PB10)
/_{M22}Step: T35.1, U1.32 (PA10)
/_{M22}~CS: T31.1, U1.25 (PB12)
/_{M22}~En: T32.1, U1.24 (PB11)
GND: C1.2, C2.2, C3.2, C7.1, C8.1, C11.2, C13.2, C14.2, C15.2, C16.2, C17.2, C18.2, C19.2, C20.2, C21.2, C22.2, C23.2, H2.1, H4.1, J1.2, J2.A1 (GND), J2.A12 (GND), J2.B1 (GND), J2.B12 (GND), J2.S1 (SHIELD), J3.2, J4.2, R1.1, R7.1, R11.1, R12.1, SW2.1, T4.1, T10.1, T16.1, T22.1, T28.1, T34.1, U1.49 (VSS), U2.2 (GND), U3.1 (GND), Y1.2, Y1.4
unnamed: D1.2 (A), L1.2, U2.1 (SW)
unnamed: D2.2 (A), R2.1
unnamed: D3.2 (A), R4.1
unnamed: F1.1, J1.1
unnamed: J2.A5 (CC1), R11.2
unnamed: J2.B5 (CC2), R12.2
unnamed: J2.A6 (D+), J2.B6 (D+), R10.1
unnamed: J2.A7 (D-), J2.B7 (D-), R9.1
unnamed: R9.2, U1.33 (PA11)
unnamed: R10.2, U1.34 (PA12)
unnamed: C7.2, U1.5 (PF0), Y1.1
unnamed: C8.2, U1.6 (PF1), Y1.3
unnamed: R3.2, SW2.2, U1.7 (PG10)
unnamed: C12.1, R7.2, R8.2, U2.3 (FB)
