calithameridi/corevus/hardware/corevus-k/corevus-k.kicad_pcb

## KiCad design hardware/corevus-k/corevus-k.kicad_pcb (2023-10-10)

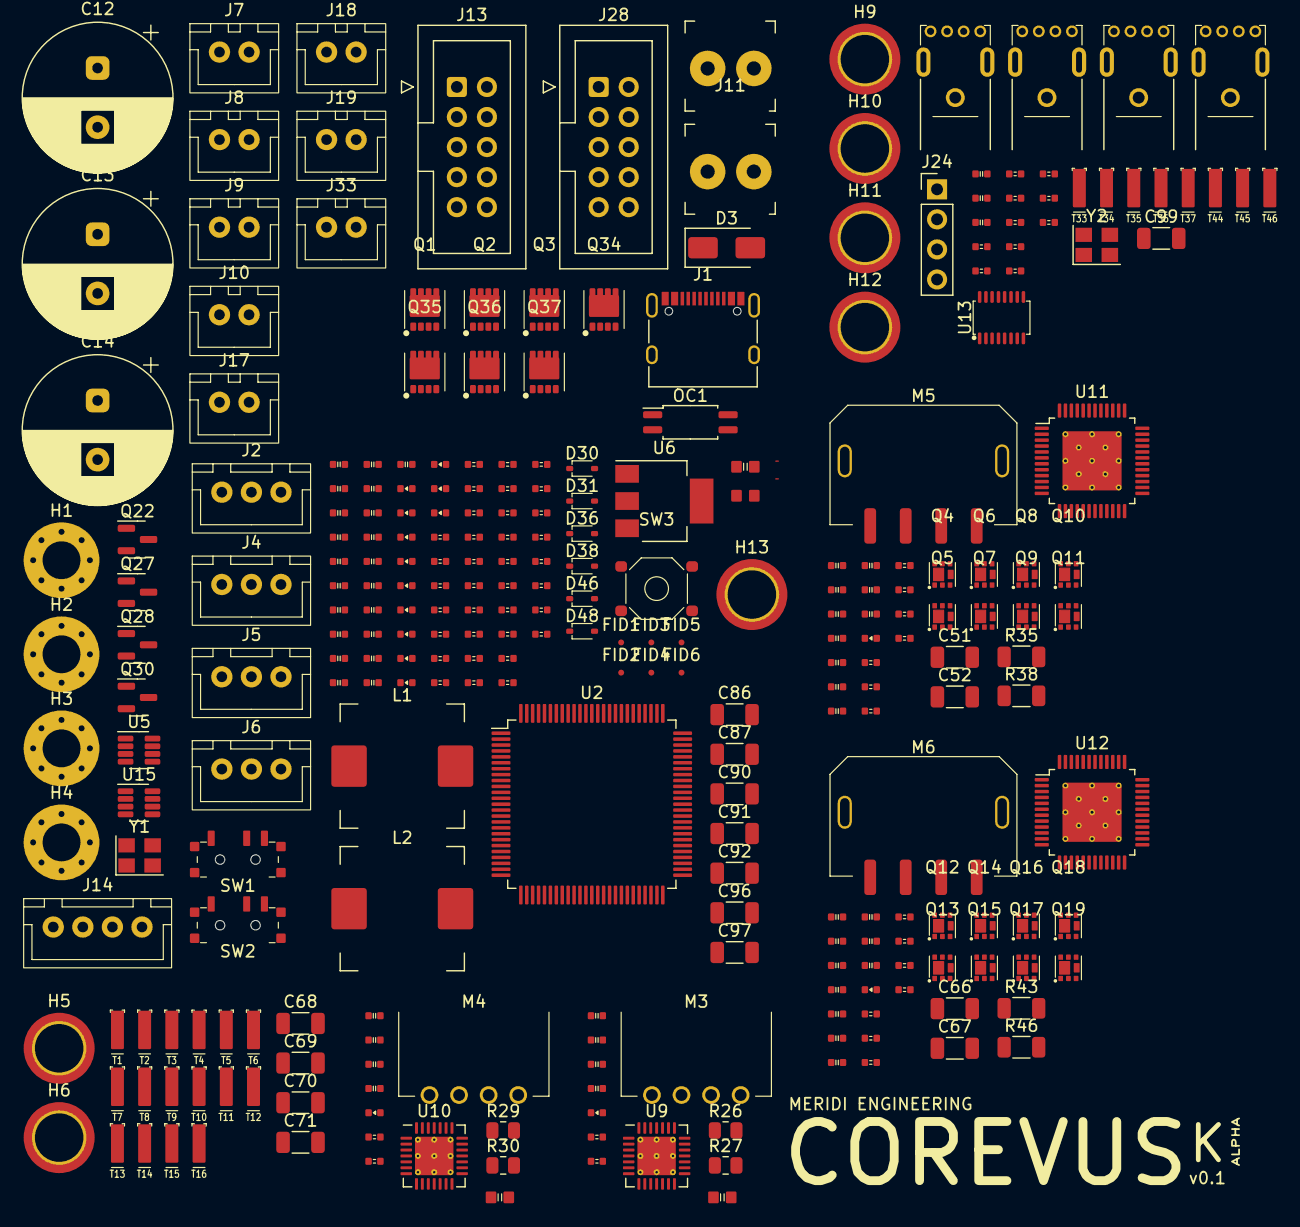
[picture p45: board corevus-k.kicad_pcb from above]

Board: 4 copper layers, 283 parts (0 on the bottom side), 186 nets, no tracks yet.

Parts:
C1, C2: 15pF; 0402C
C3, C4: 2.2μF; 0402C
C5: 100nF 50V; 0402C
C6, C7, C8, C9, C29, C34, C41, C42, C43, C45, C56, C57, C58, C60, C76, C88, C93, C94, C98: 1μF; 0402C
C11: 10μF; 0603C
C12, C13, C14: 470μF 63V; CP_Radial_D12.5mm_P5.00mm
C28, C33, C38, C79, C80, C81, C82, C83, C84, C85, C89, C95: 100nF; 0402C
C30, C35, C39, C54: 100nF 16V; 0402C
C31, C36: 22nF 50V; 0402C
C32, C37: 1μF 50V; 0603C
C40, C55: 47nF 100V; 0402C
C47, C48, C49, C50, C62, C63, C64, C65: 220nF; 0402C
C51, C52, C66, C67: 1μF 100V; C_1206_3216Metric
C68, C69, C70, C71: 1μF 63V; C_1206_3216Metric
C86, C87, C92: 10μF 50V; C_1206_3216Metric
C90, C91: 22μF 25V; C_1206_3216Metric
C96, C97: 22μF 10V; C_1206_3216Metric
C99: 22μF; C_1206_3216Metric
D1, D2, D4, D5, D6, D7, D8, D19, D20, D23, D24, D28, D29, D32, D34, D49: Red; 0402LED
D3: SS54; D_SMA
D30, D31, D36, D38: 1N4148; D_SOD-323
D46, D48: 1N5819; D_SOD-323
FB1: GZ1608; 0603
FID1, FID2, FID3, FID4, FID5, FID6: Fiducial; Fiducial_0.5mm_Mask1mm
H1, H2, H3, H4: MountingHole; MountingHole_3.2mm_M3_Pad_Via
H5: V_{M}; M3_M2.5_PCB_Nut
H6: Gnd; M3_M2.5_PCB_Nut
H9, H10, H11, H12: M2.5; M3_M2.5_PCB_Nut
H13: Back; M3_M2.5_PCB_Nut
J1: USB 2.0; USB_Type-C_16p
J2: JST XH; JST_XH_1x03
J3, J11: ScrewTerminal; DB125-3.81-2P
J4, J5, J6: XH; JST_XH_1x03
J7, J8, J9, J10, J17, J18, J19, J33: JST XH; JST_XH_1x02
J12, J15, J16, J20: USB_A; Jing_USB-A_906-761
J13: EXP1; IDC-Header_2x05_P2.54mm_Vertical
J14: JST XH; JST_XH_1x04
J24: Conn_01x05_Pin; PinHeader_1x04_P2.54mm_Vertical
J28: EXP2; IDC-Header_2x05_P2.54mm_Vertical
L1, L2: 10μH; CJiang_FXL1040
M3, M4: JST XH; JST_XH_1x04-Side
M5, M6: Micro-Fit 3.0; XKB_X3025WRS-04C
NT1, NT2: NetTie_2; NetTie-2_SMD_Pad0.1mm
OC1: PC3H7; SOP-4_4.4x2.6mm_P1.27mm
Q1, Q2, Q3, Q34, Q35, Q36, Q37: 60N03F; MOSFET_DFN8
Q4, Q5, Q6, Q7, Q8, Q9, Q10, Q11, Q12, Q13, Q14, Q15, Q16, Q17, Q18, Q19: DMT6016LFDF
Q22, Q27, Q28, Q30: AO3400; SOT-23
R1, R19, R67, R71, R72, R73, R83, R102, R105, R106, R107: 10kΩ; 0402R
R2, R10, R12, R13, R14, R96, R98, R99, R101, R103: 1kΩ; 0402R
R4, R5, R69, R70, R75, R76, R77, R78, R79, R80, R81, R82: 33Ω; 0402R
R6, R7: 5.1kΩ; 0402R
R9: 200kΩ; 0402R
R11: 100kΩ; 0402R
R15, R16, R17, R18, R39, R47, R48, R49, R54, R93: 4.7kΩ; 0402R
R26, R27, R29, R30: 100mΩ; R_0805_2012Metric
R32, R40: 2.2Ω; 0402R
R33, R34, R36, R37, R41, R42, R44, R45: 47Ω; 0402R
R35, R38, R43, R46: 33mΩ; R_1206_3216Metric
R52, R55, R104: 200Ω; 0402R
R92: 330Ω; 0402R
R94: 1.5kΩ; 0402R
R95: 8.2kΩ; 0402R
SW1, SW2: SW_SPDT; MSS12C02-LS
SW3: SPST; XKB_TS-1187A
T1: V_{SA}; LGA_Spring
T2: SClk; LGA_Spring
T3, T35: Gnd; LGA_Spring
T4: MOSI; LGA_Spring
T5: MISO; LGA_Spring
T6: V_{CC}IO; LGA_Spring
T7, T8, T9, T10, T11, T12, T13, T14, T15, T16: TestPoint; LGA_Spring
T33, T34: 5V; LGA_Spring
T36: TXD; LGA_Spring
T37: RXD; LGA_Spring
T44: Shield; LGA_Spring
T45: D+; LGA_Spring
T46: D-; LGA_Spring
U2: STM32F407VETx; LQFP-100_14x14mm_P0.5mm
U5, U15: RT8110B; TSOT-23-8
U6: AMS1117-3.3; SOT-223-3_TabPin2
U9, U10: TMC2208-LA; TMC220x
U11, U12: TMC5160A-TA; TMCx160
U13: SL2.1S
Y1: 12 MHz; Crystal_SMD_3225-4Pin_3.2x2.5mm
Y2: 12MHz; Crystal_SMD_3225-4Pin_3.2x2.5mm

Connections:
+3.3V: C11.1, C28.1, C33.1, C41.2, C56.2, C79.1, C80.1, C81.1, C82.1, C83.1, C84.1, C85.1, D19.2 (A), D20.2 (A), D23.2 (A), D24.2 (A), FB1.1, J4.3, J5.3, J6.3, R12.2, R19.1, R52.2, R55.2, R102.1, R104.2, R105.1, R106.1, R107.1, SW1.3 (C), T6.1, U2.6 (VBAT), U2.11 (VDD), U2.19 (VDD), U2.28 (VDD), U2.50 (VDD), U2.75 (VDD), U2.100 (VDD), U6.2 (VO), U9.9 (MS1), U9.10 (MS2), U9.15 (Vcc_IO), U10.9 (MS1), U10.10 (MS2), U10.15 (Vcc_IO), U11.20 (VCC_IO), U11.21 (SD_MODE), U11.22 (SPI_MODE), U12.20 (VCC_IO), U12.21 (SD_MODE), U12.22 (SPI_MODE)
+5V: C96.1, C97.1, C98.1, C99.1, D3.1 (K), J12.1 (VBUS), J13.10, J15.1 (VBUS), J16.1 (VBUS), J20.1 (VBUS), J24.1, J28.10, L2.2, R95.2, SW2.3 (C), T33.1, T34.1, U6.3 (VI), U13.7 (VDD5)
+12V: C45.2, C60.2, C90.1, C91.1, L1.2, R93.2, T1.1, U11.3 (12VOUT), U11.4 (VSA), U12.3 (12VOUT), U12.4 (VSA)
+24V: C12.1, C30.2, C32.2, C35.2, C37.2, C68.1, C69.1, C70.1, C71.1, C86.1, C87.1, C92.1, H5.1, J3.1, J11.1, Q35.5 (D), Q35.6 (D), Q35.7 (D), Q35.8 (D), Q37.5 (D), Q37.6 (D), Q37.7 (D), Q37.8 (D), SW2.1 (A), U5.7 (VIN), U9.22 (VS), U9.28 (VS), U10.22 (VS), U10.28 (VS), U15.7 (VIN)
/BOOT0: D1.2 (A), R1.1, SW1.2 (B), U2.94 (BOOT0)
/E0: D6.1 (K), J4.1
/E1: D7.1 (K), J5.1
/E2: D8.1 (K), J6.1
/F0: D5.2 (A), J14.4, R67.1
/F1_V+: D38.1 (K), J33.1
/F2_Gate: D28.2 (A), Q22.1 (G), R71.1
/F2_V+: D30.1 (K), J17.1
/F3_Gate: D29.2 (A), Q27.1 (G), R72.1
/F3_V+: D31.1 (K), J18.1
/F4_Gate: D32.2 (A), Q28.1 (G), R73.1
/F4_V+: D36.1 (K), J19.1
/F6_Gate: D34.2 (A), Q30.1 (G), R83.1
/H0_Gate: D4.2 (A), Q3.4 (G)
/HB_Gate: D2.2 (A), Q1.4 (G), Q2.4 (G)
/Motor 0 (TMCx160)/CA1: C47.1, U11.42 (CA1)
/Motor 0 (TMCx160)/CA2: C49.2, U11.35 (CA2)
/Motor 0 (TMCx160)/CB1: C48.1, U11.2 (CB1)
/Motor 0 (TMCx160)/CB2: C50.2, U11.43 (CB2)
/Motor 0 (TMCx160)/HA1: Q6.3 (G), U11.41 (HA1)
/Motor 0 (TMCx160)/HA2: Q4.3 (G), U11.36 (HA2)
/Motor 0 (TMCx160)/HB1: Q10.3 (G), U11.1 (HB1)
/Motor 0 (TMCx160)/HB2: Q8.3 (G), U11.44 (HB2)
/Motor 0 (TMCx160)/LA1: Q7.3 (G), U11.39 (LA1)
/Motor 0 (TMCx160)/LA2: Q5.3 (G), U11.38 (LA2)
/Motor 0 (TMCx160)/LB1: Q11.3 (G), U11.47 (LB1)
/Motor 0 (TMCx160)/LB2: Q9.3 (G), U11.46 (LB2)
/Motor 0 (TMCx160)/Motor_A1: C47.2, M5.3, Q6.4 (S), Q6.7 (S), Q7.1 (D), Q7.2 (D), Q7.5 (D), Q7.6 (D), Q7.8 (D), U11.40 (BMA1)
/Motor 0 (TMCx160)/Motor_A2: C49.1, M5.4, Q4.4 (S), Q4.7 (S), Q5.1 (D), Q5.2 (D), Q5.5 (D), Q5.6 (D), Q5.8 (D), U11.37 (BMA2)
/Motor 0 (TMCx160)/Motor_B1: C48.2, M5.1, Q10.4 (S), Q10.7 (S), Q11.1 (D), Q11.2 (D), Q11.5 (D), Q11.6 (D), Q11.8 (D), U11.48 (BMB1)
/Motor 0 (TMCx160)/Motor_B2: C50.1, M5.2 (-), Q8.4 (S), Q8.7 (S), Q9.1 (D), Q9.2 (D), Q9.5 (D), Q9.6 (D), Q9.8 (D), U11.45 (BMB2)
/Motor 0 (TMCx160)/SRAH: R33.2, U11.8 (SRAH)
/Motor 0 (TMCx160)/SRAL: R34.2, U11.7 (SRAL)
/Motor 0 (TMCx160)/SRBH: R36.2, U11.9 (SRBH)
/Motor 0 (TMCx160)/SRBL: R37.2, U11.10 (SRBL)
/Motor 1 (TMCx160)/CA1: C62.1, U12.42 (CA1)
/Motor 1 (TMCx160)/CA2: C64.2, U12.35 (CA2)
/Motor 1 (TMCx160)/CB1: C63.1, U12.2 (CB1)
/Motor 1 (TMCx160)/CB2: C65.2, U12.43 (CB2)
/Motor 1 (TMCx160)/HA1: Q14.3 (G), U12.41 (HA1)
/Motor 1 (TMCx160)/HA2: Q12.3 (G), U12.36 (HA2)
/Motor 1 (TMCx160)/HB1: Q18.3 (G), U12.1 (HB1)
/Motor 1 (TMCx160)/HB2: Q16.3 (G), U12.44 (HB2)
/Motor 1 (TMCx160)/LA1: Q15.3 (G), U12.39 (LA1)
/Motor 1 (TMCx160)/LA2: Q13.3 (G), U12.38 (LA2)
/Motor 1 (TMCx160)/LB1: Q19.3 (G), U12.47 (LB1)
/Motor 1 (TMCx160)/LB2: Q17.3 (G), U12.46 (LB2)
/Motor 1 (TMCx160)/Motor_A1: C62.2, M6.3, Q14.4 (S), Q14.7 (S), Q15.1 (D), Q15.2 (D), Q15.5 (D), Q15.6 (D), Q15.8 (D), U12.40 (BMA1)
/Motor 1 (TMCx160)/Motor_A2: C64.1, M6.4, Q12.4 (S), Q12.7 (S), Q13.1 (D), Q13.2 (D), Q13.5 (D), Q13.6 (D), Q13.8 (D), U12.37 (BMA2)
/Motor 1 (TMCx160)/Motor_B1: C63.2, M6.1, Q18.4 (S), Q18.7 (S), Q19.1 (D), Q19.2 (D), Q19.5 (D), Q19.6 (D), Q19.8 (D), U12.48 (BMB1)
/Motor 1 (TMCx160)/Motor_B2: C65.1, M6.2 (-), Q16.4 (S), Q16.7 (S), Q17.1 (D), Q17.2 (D), Q17.5 (D), Q17.6 (D), Q17.8 (D), U12.45 (BMB2)
/Motor 1 (TMCx160)/SRAH: R41.2, U12.8 (SRAH)
/Motor 1 (TMCx160)/SRAL: R42.2, U12.7 (SRAL)
/Motor 1 (TMCx160)/SRBH: R44.2, U12.9 (SRBH)
/Motor 1 (TMCx160)/SRBL: R45.2, U12.10 (SRBL)
/Motor 2 (TMC2208)/A1: M3.2 (-), U9.24 (OA1)
/Motor 2 (TMC2208)/A2: M3.1, U9.21 (OA2)
/Motor 2 (TMC2208)/B1: M3.3, U9.26 (OB1)
/Motor 2 (TMC2208)/B2: M3.4, U9.1 (OB2)
/Motor 2 (TMC2208)/BRA: R26.1, U9.23 (BRA)
/Motor 2 (TMC2208)/BRB: R27.1, U9.27 (BRB)
/Motor 3 (TMC2208)/A1: M4.2 (-), U10.24 (OA1)
/Motor 3 (TMC2208)/A2: M4.1, U10.21 (OA2)
/Motor 3 (TMC2208)/B1: M4.3, U10.26 (OB1)
/Motor 3 (TMC2208)/B2: M4.4, U10.1 (OB2)
/Motor 3 (TMC2208)/BRA: R29.1, U10.23 (BRA)
/Motor 3 (TMC2208)/BRB: R30.1, U10.27 (BRB)
/Pi Zero + USB Hub/D1+: R75.2, U13.4 (DP1)
/Pi Zero + USB Hub/D1+': J12.3 (D+), R75.1
/Pi Zero + USB Hub/D1-: R76.2, U13.3 (DM1)
/Pi Zero + USB Hub/D1-': J12.2 (D-), R76.1
/Pi Zero + USB Hub/D2+: R77.2, U13.2 (DP2)
/Pi Zero + USB Hub/D2+': J15.3 (D+), R77.1
/Pi Zero + USB Hub/D2-: R78.2, U13.1 (DM2)
/Pi Zero + USB Hub/D2-': J15.2 (D-), R78.1
/Pi Zero + USB Hub/D3+: R79.2, U13.16 (DP3)
/Pi Zero + USB Hub/D3+': J16.3 (D+), R79.1
/Pi Zero + USB Hub/D3-: R80.2, U13.15 (DM3)
/Pi Zero + USB Hub/D3-': J16.2 (D-), R80.1
/Pi Zero + USB Hub/D4+: R81.2, U13.14 (DP4)
/Pi Zero + USB Hub/D4+': J20.3 (D+), R81.1
/Pi Zero + USB Hub/D4-: R82.2, U13.13 (DM4)
/Pi Zero + USB Hub/D4-': J20.2 (D-), R82.1
/Pi Zero + USB Hub/DU+: R69.1, U13.6 (UDP)
/Pi Zero + USB Hub/DU+': R69.2, T45.1
/Pi Zero + USB Hub/DU-: R70.1, U13.5 (UDM)
/Pi Zero + USB Hub/DU-': R70.2, T46.1
/Probe: OC1.3, R11.1, R96.2
/SPI1_MISO: T5.1, U11.16 (SDO/CFG0), U12.16 (SDO/CFG0)
/SPI1_MOSI: T4.1, U11.15 (SDI/CFG1), U12.15 (SDI/CFG1)
/SPI1_SCK: T2.1, U11.14 (SCK/CFG2), U12.14 (SCK/CFG2)
/T0: C6.2, J8.2, R15.1
/T1: C7.2, J7.2, R16.1
/T2: C8.2, J9.2, R17.1
/T3: C9.2, J10.2, R18.1
/USART2_RX: J24.3, T36.1
/USART2_TX: J24.4, T37.1
/_{M0}~En: R99.2, R107.2, U12.28 (~DRV_EN)
/_{M2}~En: R101.2, R102.2, U9.2 (~En)
/_{M3}~En: R103.2, R105.2, U10.2 (~En)
/_{M4}~En: R98.2, R106.2, U11.28 (~DRV_EN)
GND: C1.1, C2.1, C3.2, C4.2, C5.2, C11.2, C12.2, C13.2, C14.2, C28.2, C29.1, C32.1, C33.2, C34.1, C37.1, C38.2, C41.1, C42.1, C43.1, C45.1, C51.2, C52.2, C56.1, C57.1, C58.1, C60.1, C66.2, C67.2, C68.2, C69.2, C70.2, C71.2, C76.2, C79.2, C80.2, C81.2, C82.2, C83.2, C84.2, C85.2, C86.2, C87.2, C88.2, C90.2, C91.2, C92.2, C93.2, C94.2, C96.2, C97.2, C98.2, C99.2, D49.1 (K), H6.1, H9.1, H10.1, H11.1, H12.1, J1.A1 (GND), J1.A12 (GND), J1.B1 (GND), J1.B12 (GND), J1.S1 (SHIELD), J2.2, J4.2, J5.2, J6.2, J12.4 (GND), J12.5 (Shield), J13.9, J14.2, J15.4 (GND), J15.5 (Shield), J16.4 (GND), J16.5 (Shield), J20.4 (GND), J20.5 (Shield), J24.2, J28.9, NT1.1, OC1.2, Q1.1 (S), Q1.2 (S), Q1.3 (S), Q2.1 (S), Q2.2 (S), Q2.3 (S), Q3.1 (S), Q3.2 (S), Q3.3 (S), Q22.2 (S), Q27.2 (S), Q28.2 (S), Q30.2 (S), Q34.1 (S), Q34.2 (S), Q34.3 (S), Q36.1 (S), Q36.2 (S), Q36.3 (S), R1.2, R2.1, R6.1, R7.1, R9.2, R11.2, R13.2, R14.2, R26.2, R27.2, R29.2, R30.2, R34.1, R35.2, R37.1, R38.2, R39.2, R42.1, R43.2, R45.1, R46.2, R47.2, R48.2, R49.2, R54.2, R67.2, R71.2, R72.2, R73.2, R83.2, R92.2, R94.2, SW1.1 (A), SW3.1, T3.1, T9.1, T10.1, T35.1, T44.1, U2.10 (VSS), U2.27 (VSS), U2.74 (VSS), U2.99 (VSS), U5.3 (GND), U6.1 (GND), U9.3 (Gnd), U9.7 (NC), U9.18 (Gnd), U9.20 (NC), U9.25 (NC), U9.29 (Pad), U10.3 (Gnd), U10.7 (NC), U10.18 (Gnd), U10.20 (NC), U10.25 (NC), U10.29 (Pad), U11.6 (GNDA), U11.11 (TST_MODE), U11.12 (CLK), U11.19 (GNDD), U11.30 (GNDD), U11.49 (EP), U12.6 (GNDA), U12.11 (TST_MODE), U12.12 (CLK), U12.19 (GNDD), U12.30 (GNDD), U12.49 (EP), U13.8 (VSS), U15.3 (GND), Y1.2, Y1.4, Y2.2, Y2.4
unnamed: D1.1 (K), R2.2
unnamed: D2.1 (K), R13.1
unnamed: D3.2 (A), J1.A4 (VBUS), J1.A9 (VBUS), J1.B4 (VBUS), J1.B9 (VBUS)
unnamed: D4.1 (K), R14.1
unnamed: D5.1 (K), R49.1
unnamed: D6.2 (A), R52.1
unnamed: D7.2 (A), R55.1
unnamed: D8.2 (A), R104.1
unnamed: D19.1 (K), R98.1
unnamed: D20.1 (K), R99.1
unnamed: D23.1 (K), R101.1
unnamed: D24.1 (K), R103.1
unnamed: D28.1 (K), R39.1
unnamed: D29.1 (K), R47.1
unnamed: D30.2 (A), J17.2, Q22.3 (D)
unnamed: D31.2 (A), J18.2, Q27.3 (D)
unnamed: D32.1 (K), R48.1
unnamed: D34.1 (K), R54.1
unnamed: D36.2 (A), J19.2, Q28.3 (D)
unnamed: D38.2 (A), J33.2, Q30.3 (D)
unnamed: C88.1, D46.2 (A), U15.1 (VCC)
unnamed: C89.1, D46.1 (K), U15.5 (BOOT)
unnamed: C94.1, D48.2 (A), U5.1 (VCC)
unnamed: C95.1, D48.1 (K), U5.5 (BOOT)
unnamed: D49.2 (A), R96.1
unnamed: J1.A5 (CC1), R6.2
unnamed: J1.B5 (CC2), R7.2
unnamed: J1.A6 (D+), J1.B6 (D+), R5.2
unnamed: J1.A7 (D-), J1.B7 (D-), R4.2
unnamed: C5.1, J2.1, SW2.2 (B)
unnamed: J2.3, R10.1
unnamed: J3.2, Q3.5 (D), Q3.6 (D), Q3.7 (D), Q3.8 (D)
unnamed: J11.2, Q1.5 (D), Q1.6 (D), Q1.7 (D), Q1.8 (D), Q2.5 (D), Q2.6 (D), Q2.7 (D), Q2.8 (D)
unnamed: OC1.1, R10.2
unnamed: OC1.4, R12.1
unnamed: Q5.4 (S), Q5.7 (S), Q7.4 (S), Q7.7 (S), R33.1, R35.1
unnamed: Q9.4 (S), Q9.7 (S), Q11.4 (S), Q11.7 (S), R36.1, R38.1
unnamed: Q13.4 (S), Q13.7 (S), Q15.4 (S), Q15.7 (S), R41.1, R43.1
unnamed: Q17.4 (S), Q17.7 (S), Q19.4 (S), Q19.7 (S), R44.1, R46.1
unnamed: Q34.4 (G), U15.2 (LGATE)
unnamed: Q35.4 (G), U15.4 (UGATE)
unnamed: Q36.4 (G), U5.2 (LGATE)
unnamed: Q37.4 (G), U5.4 (UGATE)
unnamed: C38.1, R19.2, SW3.2, U2.14 (NRST)
unnamed: R4.1, U2.70 (PA11)
unnamed: R5.1, U2.71 (PA12)
unnamed: C1.2, U2.12 (PH0), Y1.1
unnamed: C2.2, U2.13 (PH1), Y1.3
unnamed: C4.1, U2.49 (VCAP_1)
unnamed: C3.1, U2.73 (VCAP_2)
unnamed: NT2.2, U2.21 (VREF+)
unnamed: R94.1, R95.1, U5.8 (FB)
unnamed: C95.2, L2.1, Q36.5 (D), Q36.6 (D), Q36.7 (D), Q36.8 (D), Q37.1 (S), Q37.2 (S), Q37.3 (S), U5.6 (PHASE)
unnamed: C29.2, U9.8 (5VOut)
unnamed: C31.2, U9.5 (CPI)
unnamed: C31.1, U9.4 (CPO)
unnamed: C30.1, U9.6 (VCP)
unnamed: C34.2, U10.8 (5VOut)
unnamed: C36.2, U10.5 (CPI)
unnamed: C36.1, U10.4 (CPO)
unnamed: C35.1, U10.6 (VCP)
unnamed: C42.2, R32.1, U11.5 (5VOUT)
unnamed: C40.1, U11.32 (CPI)
unnamed: C40.2, U11.31 (CPO)
unnamed: C43.2, R32.2, U11.29 (VCC)
unnamed: C39.1, U11.34 (VCP)
unnamed: C57.2, R40.1, U12.5 (5VOUT)
unnamed: C55.1, U12.32 (CPI)
unnamed: C55.2, U12.31 (CPO)
unnamed: C58.2, R40.2, U12.29 (VCC)
unnamed: C54.1, U12.34 (VCP)
unnamed: C76.1, U13.10 (VDD18)
unnamed: C93.1, U13.9 (VDD33)
unnamed: U13.12 (XIN), Y2.1
unnamed: U13.11 (XOUT), Y2.3
unnamed: R92.1, R93.1, U15.8 (FB)
unnamed: C89.2, L1.1, Q34.5 (D), Q34.6 (D), Q34.7 (D), Q34.8 (D), Q35.1 (S), Q35.2 (S), Q35.3 (S), U15.6 (PHASE)
VDDA: FB1.2, NT2.1, R15.2, R16.2, R17.2, R18.2, U2.22 (VDDA)
VMB: C13.1, C14.1, C39.2, C51.1, C52.1, C54.2, C66.1, C67.1, Q4.1 (D), Q4.2 (D), Q4.5 (D), Q4.6 (D), Q4.8 (D), Q6.1 (D), Q6.2 (D), Q6.5 (D), Q6.6 (D), Q6.8 (D), Q8.1 (D), Q8.2 (D), Q8.5 (D), Q8.6 (D), Q8.8 (D), Q10.1 (D), Q10.2 (D), Q10.5 (D), Q10.6 (D), Q10.8 (D), Q12.1 (D), Q12.2 (D), Q12.5 (D), Q12.6 (D), Q12.8 (D), Q14.1 (D), Q14.2 (D), Q14.5 (D), Q14.6 (D), Q14.8 (D), Q16.1 (D), Q16.2 (D), Q16.5 (D), Q16.6 (D), Q16.8 (D), Q18.1 (D), Q18.2 (D), Q18.5 (D), Q18.6 (D), Q18.8 (D), R9.1, U11.33 (VS), U12.33 (VS)
VSSA: C6.1, C7.1, C8.1, C9.1, J7.1, J8.1, J9.1, J10.1, NT1.2, U2.20 (VSSA)
