calithameridi/corevus/(commit log)

2023-06-15 initialized project
    [corevus.kicad_pcb, corevus.kicad_sch]
2023-06-18 test reworking of directory structure
    [corevus.kicad_pcb, corevus.kicad_sch]
2023-06-23 added preliminary LGA layout for motor expansion module
    [driver-tmc5160.kicad_pcb, driver-tmc5160.kicad_sch]
2023-07-22 further work on motor drivers and connector layout, additional symbols/footprints/models
    [driver-tmc2208-integrated.kicad_sch, driver-tmc5160-integrated.kicad_sch, driver-tmc5160.kicad_pcb, driver-tmc5160.kicad_sch, driver_expansion.kicad_sch, driver_tmc2209_integrated.kicad_sch, mainboard.kicad_pcb, mainboard.kicad_sch]
2023-07-28 added fan / heater ports to mainboard, and footprints for switches, transistors, etc.
    [driver-fan-2pin-dual.kicad_sch, driver-tmc2208-integrated.kicad_sch, driver-tmc5160-integrated.kicad_sch, driver_expansion.kicad_sch, driver_heater.kicad_sch, mainboard.kicad_pcb, mainboard.kicad_sch, pi-zero.kicad_sch]
2023-08-09 saving mainboard, gonna tear out the entire thing and redo in 4-layer
    [driver-fan-2pin-dual.kicad_sch, driver-tmc2208-integrated.kicad_sch, driver-tmc5160-integrated.kicad_sch, driver_expansion.kicad_sch, driver_heater.kicad_sch, mainboard.kicad_pcb, mainboard.kicad_sch, pi-zero.kicad_sch]
2023-08-19 further board edits, mostly done with power planes, heaters, fans, motor channels, starting work on microcontroller signals
    [driver-fan-2pin-dual.kicad_sch, driver-tmc2208-integrated.kicad_sch, driver-tmc5160-integrated.kicad_sch, driver_expansion.kicad_sch, driver_heater.kicad_sch, mainboard.kicad_sch, pi-zero.kicad_sch]
2023-08-24 redid mainboard, added probe wiring, replacing ncp chip with LM5160 for now
    [driver-tmc2208-integrated.kicad_sch, driver-tmc5160-integrated.kicad_sch, driver-tmc5160.kicad_pcb, driver-tmc5160.kicad_sch, driver_expansion.kicad_sch, mainboard.kicad_sch, pi-zero.kicad_sch]
2023-08-30 nearing first prototype woot! copyediting over entire board, fixed some mistakes
    [driver-tmc2208-integrated.kicad_sch, driver-tmc5160-integrated.kicad_sch, driver-tmc5160.kicad_pcb, driver-tmc5160.kicad_sch, driver_expansion.kicad_sch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]
2023-08-31 test new gitignore with completed mainboard
    [driver-tmc5160-integrated.kicad_sch, driver-tmc5160.kicad_pcb, driver-tmc5160.kicad_sch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]
2023-09-05 redoing board for version alpha 0.2
    [driver-fan-2pin-dual.kicad_sch, driver-tmc2208-integrated.kicad_sch, driver-tmc5160-integrated.kicad_sch, driver_expansion.kicad_sch, driver_heater.kicad_sch, mainboard.kicad_sch, pi-zero.kicad_sch]
2023-09-09 added components and further work on PCB layout design
    [driver-tmc5160-integrated.kicad_sch, driver-tmc5160.kicad_pcb, mainboard.kicad_pcb, mainboard.kicad_sch]
2023-09-21 tested SMD style XH connectors — didn't work very well alas
    [driver-fan-2pin-dual.kicad_sch, driver-tmc2208-integrated.kicad_sch, driver-tmc5160-integrated.kicad_sch, driver_heater.kicad_sch, mainboard.kicad_sch, pi-zero.kicad_sch]
2023-09-26 fan ports
    [driver-tmc2208-integrated.kicad_sch, driver-tmc5160-integrated.kicad_sch, driver_heater.kicad_sch, mainboard.kicad_sch, pi-zero.kicad_sch]
2023-09-29 this is immediately before i switch the terminus USB hub with the corechips
    [driver-tmc2208-integrated.kicad_sch, driver-tmc5160-integrated.kicad_sch, mainboard.kicad_sch]
2023-09-29 v0.2 feature complete
    [mainboard.kicad_sch, pi-zero.kicad_sch]
2023-10-01 added more 3D models and created first few renders
    [dfm-board-1.kicad_pcb, dfm-board-1.kicad_sch, driver-tmc2208-integrated.kicad_sch, driver-tmc5160-integrated.kicad_sch, driver-tmc5160.kicad_pcb, driver-tmc5160.kicad_sch, mainboard.kicad_sch, pi-zero.kicad_sch]
2023-10-08 adopt corevus-g designation for current mainboard, cleanup
    [corevus-g.kicad_sch, corevus-m.kicad_pcb, corevus-m.kicad_sch, driver-fan-2pin-dual.kicad_sch, driver-tmc2208-integrated.kicad_sch, driver-tmc5160-integrated.kicad_sch, driver-tmc5160.kicad_pcb, driver-tmc5160.kicad_sch]
2023-10-10 finish corevus-g, create file for corevus-k
    [corevus-g.kicad_sch, corevus-k.kicad_pcb, corevus-k.kicad_sch, corevus-m.kicad_pcb, corevus-m.kicad_sch, driver-fan-2pin-dual.kicad_sch, driver-tmc2208-integrated.kicad_sch, driver-tmc5160-integrated.kicad_sch]
2023-10-17 add'l work on tmc2160 driver, i think i'm finally converging on a layout i'm satisfied with
    [corevus-g.kicad_sch, driver-tmc2160.kicad_pcb, driver-tmc2160.kicad_sch, driver-tmc5160-integrated.kicad_sch]
2023-11-26 just discovered that corevus-g v0.3 cooks itself wonderful
    [corevus-g-B_Cu.gbr, corevus-g-B_Fab.gbr, corevus-g-B_Mask.gbr, corevus-g-B_Paste.gbr, corevus-g-B_Silkscreen.gbr, corevus-g-Edge_Cuts.gbr, corevus-g-F_Cu.gbr, corevus-g-F_Fab.gbr]
2023-12-12 weird fucking shit where CvG-v0.3 schematics went poof
    [corevus-m++.kicad_pcb, corevus-m++.kicad_sch]
2023-12-16 version control appears to have magically disappeared the single and dual 2160 driver files :(((((((((, but got some work done on CvG nonetheless
    [corevus-g.kicad_sch, driver-tmc2160-integrated.kicad_sch, driver-tmc2208-integrated.kicad_sch, driver_expansion.kicad_sch, driver_heater.kicad_sch]
2024-01-08 v0.4 mostly complete, board needs minor revisions (e.g. pin swap)
    [corevus-g.kicad_sch, corevus-t.kicad_pcb, corevus-t.kicad_sch, driver-tmc2160-integrated.kicad_sch, driver-tmc2160.kicad_pcb, driver-tmc2160.kicad_sch, driver-tmc2208-integrated.kicad_sch, driver_expansion.kicad_sch]
2024-01-28 CvG v0.4 complete, now updating documentation
    [corevus-g.kicad_sch, corevus-t.kicad_pcb, corevus-t.kicad_sch, corevus-toolboard.kicad_pcb, corevus-toolboard.kicad_sch, driver-fan-2pin-dual.kicad_sch, driver-tmc2160-5A.kicad_pcb, driver-tmc2160-5A.kicad_sch]
2024-02-10 updated with h723 fix workaround info
    [corevus-toolboard.kicad_pcb]
2024-02-12 polished footprints
2024-02-15 non-working commit, moved around various connectors etc in preparation for v0.5
    [corevus-g.kicad_sch, driver_heater.kicad_sch]
2024-03-24 this should be hardware revs of CvG v0.5 (broken), CvM++ v0.1 (broken, also not final name), and the tmc2209 driver
    [corevus-g.kicad_sch, corevus-m++.kicad_pcb, corevus-m++.kicad_sch, corevus-m++.step, corevus-toolboard.kicad_pcb, corevus-toolboard.kicad_sch, driver-tmc2160-integrated.kicad_sch, driver-tmc2208-integrated.kicad_sch]
2024-04-05 corevus toolboard v0.2 release (working), corevus-g v0.2 release (very much not working), m++ v0.1 (not working, needs a lot of bodges)
    [corevus-g.kicad_sch, corevus-k.kicad_pcb, corevus-k.kicad_sch, corevus-m++.kicad_pcb, corevus-m++.kicad_sch, corevus-m++.step, corevus-m.kicad_pcb, corevus-m.kicad_sch]
2024-04-15 made some edit to footprints. also my previous commit should have specified cvg v0.5 borked, not v0.2
2024-04-16 v0.3 toolboard nearing completion (just need to make the production files), also made panelization test board
    [corevus-toolboard-panelize.kicad_pcb, corevus-toolboard.kicad_pcb, corevus-toolboard.kicad_sch]
2024-04-17 finished production data for toolboard v0.3, just waiting on parts eeeeeeee
    [corevus-toolboard-panelize2.kicad_pcb, corevus-toolboard.kicad_pcb, corevus-toolboard.kicad_sch]
2024-05-07 why not
    [corevus-g.kicad_sch, driver-tmc2160-integrated.kicad_sch, driver-tmc2209-integrated.kicad_sch, driver_heater.kicad_sch, toolboard-bridge.kicad_pcb, toolboard-bridge.kicad_sch]
2024-05-26 should be up to date for cvg v0.6 and latest protected drivers
    [corevus-g.kicad_sch, corevus-toolboard.kicad_pcb, corevus-toolboard.kicad_sch, driver-tmc2160-integrated.kicad_sch, driver-tmc2160.kicad_pcb, driver-tmc2160.kicad_sch, driver-tmc2209-integrated.kicad_sch, driver-tmc2209.kicad_pcb]
2024-06-18 Added details on fan / motor voltage selection
    [corevus-g.kicad_sch, corevus-toolboard.kicad_pcb, corevus-toolboard.kicad_sch]
2024-07-09 added ctb v0.3 and dual 2160, fixed typo in v0.6 manual
    [corevus-toolboard.kicad_pcb, corevus-toolboard.kicad_sch, driver-dual-tmc2160.kicad_pcb, driver-dual-tmc2160.kicad_sch, driver-tmc5160.kicad_pcb, driver-tmc5160.kicad_sch]
2024-07-24 last before i go on v0.7
    [corevus-toolboard.kicad_pcb, corevus-toolboard.kicad_sch, driver-dual-tmc2160.kicad_pcb, driver-dual-tmc2160.kicad_sch]
2024-08-08 cleaned up corevus toolboard schematics to be more presentable
    [corevus-toolboard.kicad_pcb, corevus-toolboard.kicad_sch, expansion-max31855.kicad_pcb, expansion-max31855.kicad_sch, toolboard-bridge.kicad_pcb, toolboard-bridge.kicad_sch]
2024-08-13 48v extruder driver first prototype, dual tmc2160 polish for next rev
    [driver-dual-tmc2160.kicad_pcb, driver-tmc2160-heater.kicad_pcb, driver-tmc2160-heater.kicad_sch]
2024-08-15 last commit before i delete 2 layers from the dual tmc2160
    [driver-dual-tmc2160.kicad_pcb]
2024-09-03 Added STEP and Parasolid mechanical files for Corevus-G v0.6, added TMC2160 + Heater module, added toolboard 4x thermistor expansion, added toolboard MAX31856 thermocouple ADC expansion
    [corevus-toolboard.kicad_pcb, corevus-toolboard.kicad_sch, driver-dual-tmc2160.kicad_pcb, driver-tmc2160-heater.kicad_pcb, driver-tmc2160-heater.kicad_sch, expansion-4x-thermistor.kicad_pcb, expansion-4x-thermistor.kicad_sch, expansion-max31855.kicad_pcb]
2024-09-11 added corevus driver module images and documentation
2025-02-08 update toolboard, change documentation
    [corevus-toolboard.kicad_pcb, corevus-toolboard.kicad_sch, driver-dual-tmc2160.kicad_pcb, driver-dual-tmc2160.kicad_sch, driver-tmc2160-heater.kicad_pcb]
